sparkfun/SparkFun_Tristimulus_Color_Sensor-OPT4048/docs/examples.md

###Example 1: Basic Color Sensing

This first example just does some basic measurements. To find Example 1, go to **File** > **Examples** > **SparkFun Color Sensor OPT4048** > **example1_BasicColorSensing**:

<figure markdown>
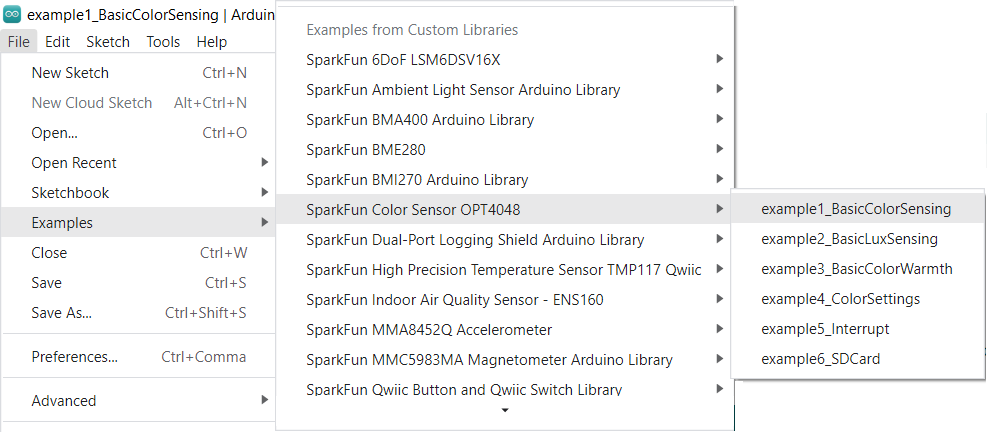
[picture p19: docs/assets/img/Example1_Menu.png]
Color Sensor OPT4048 Arduino Example 1

<figcaption markdown>Finding Example 1</figcaption>
</figure>

Alternatively, you can expand the link below and copy and paste the code into a shiny new Arduino sketch: 

??? "Example 1: Basic Color Sensing"
	```
	--8<-- "https://raw.githubusercontent.com/sparkfun/SparkFun_OPT4048_Arduino_Library/main/examples/example1_BasicColorSensing/example1_BasicColorSensing.ino"
	```

Make sure you've selected the correct board and port in the Tools menu and then hit the upload button. Once the code has finished uploading, go ahead and open a [Serial Monitor](https://learn.sparkfun.com/tutorials/terminal-basics). You should see something similar to the following. 

<figure markdown>
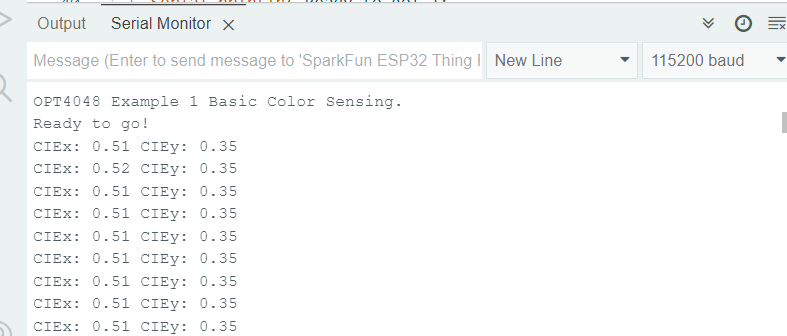
[picture p20: docs/assets/img/Example1_Output.png]
Color Sensor OPT4048 Arduino Example 1

<figcaption markdown>Example 1 Output</figcaption>
</figure>

The CIEx and CIEy values are going to fall somewhere between 0 and 1. Page 35 of the [datasheet](assets/board_files/opt4048.pdf) gives more detail on this, but generally speaking, you can map the predominant color of the space you're measuring using the following: 

<figure markdown>
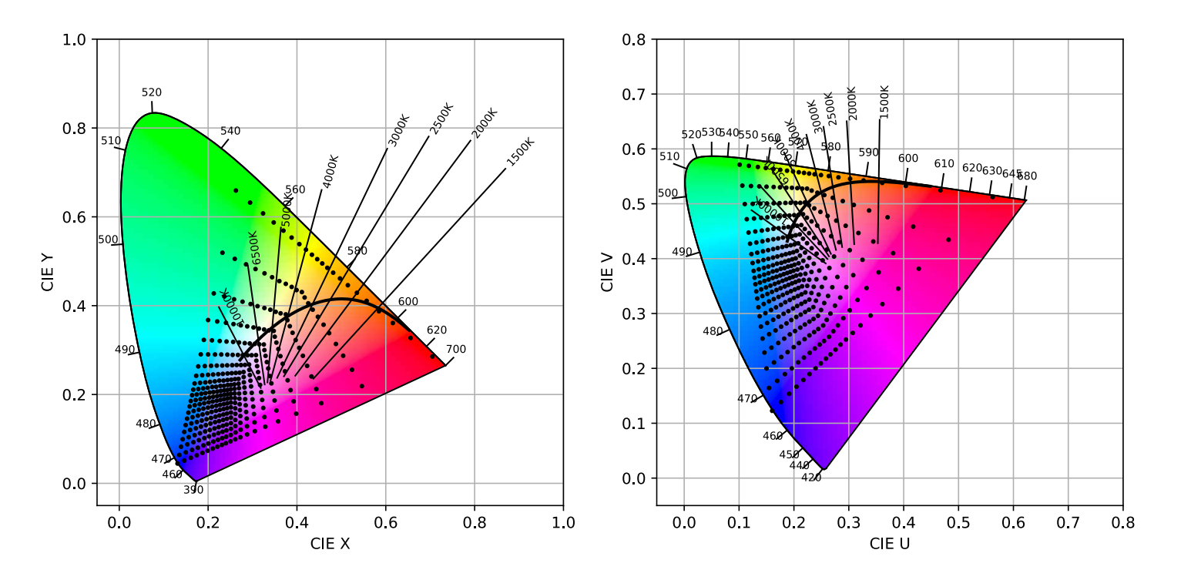
[picture p21: docs/assets/img/CIEMap.png]

<figcaption markdown>CIE XY and CIE UV space plots of color coordinates</figcaption>
</figure>

For more information on the CIE and CIY values, refer to the [CIE 1931 Color Space Wiki Page](https://en.wikipedia.org/wiki/CIE_1931_color_space).

###Example 2: Basic Lux Readings

This example measures the lux readings of the surrounding environment. To find Example 2, go to **File** > **Examples** > **SparkFun Color Sensor OPT4048** > **example2_BasicLuxSensing**:

<figure markdown>
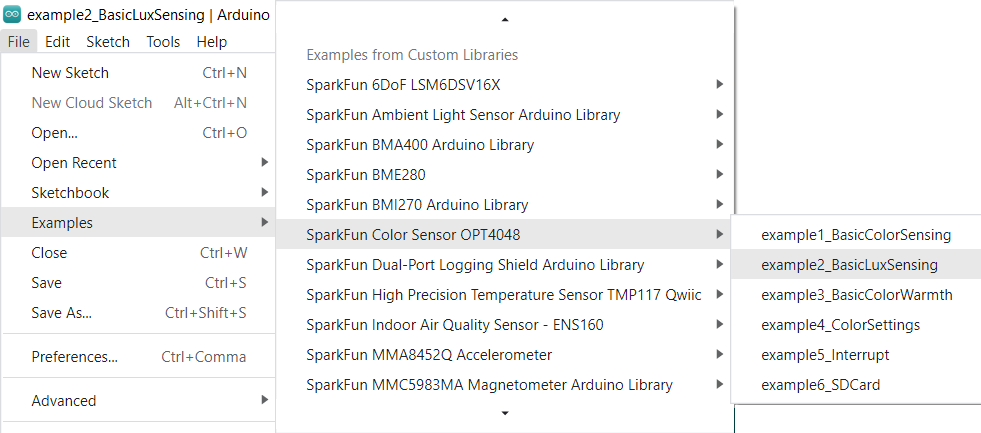
[picture p22: docs/assets/img/Example2_Menu.png]
Color Sensor OPT4048 Arduino Example 2

<figcaption markdown>Finding Example 2</figcaption>
</figure>

Alternatively, you can expand the link below and copy and paste the code into a shiny new Arduino sketch: 

??? "Example 2: Basic Lux Sensing Arduino Code"
	```
	--8<-- "https://raw.githubusercontent.com/sparkfun/SparkFun_OPT4048_Arduino_Library/main/examples/example2_BasicLuxSensing/example2_BasicLuxSensing.ino"
	```
 
Make sure you've selected the correct board and port in the Tools menu and then hit the upload button. Once the code has finished uploading, go ahead and open a [Serial Monitor](https://learn.sparkfun.com/tutorials/terminal-basics). You should see something similar to the following. 

<figure markdown>
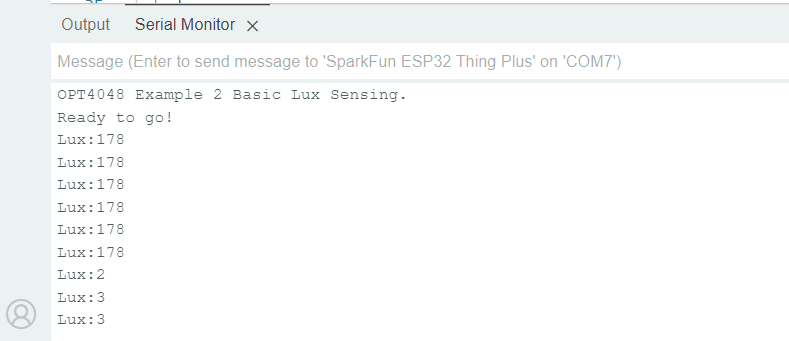
[picture p23: docs/assets/img/Example2_Output.png]
Color Sensor OPT4048 Arduino Example 2

<figcaption markdown>Example 2 Output</figcaption>
</figure>

Lux values will be measured anywhere from 2.15 mlux to 144 klux. Measurements here start at my general office lighting, and then I put my finger over the sensor. 

###Example 3: Basic Color Warmth

This example measures the basic color warmth. To find Example 3, go to **File** > **Examples** > **SparkFun Color Sensor OPT4048** > **example3_BasicColorWarmth**:

<figure markdown>
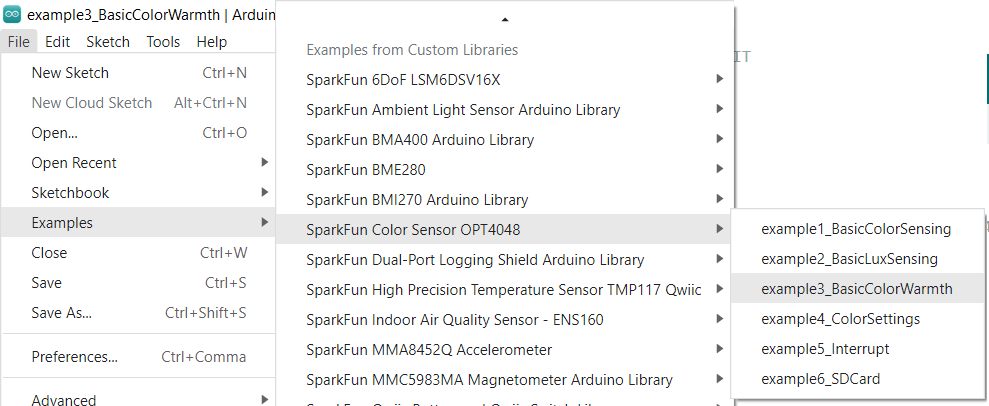
[picture p24: docs/assets/img/Example3_Menu.png]
Color Sensor OPT4048 Arduino Example 3

<figcaption markdown>Finding Example 3</figcaption>
</figure>

Alternatively, you can expand the link below and copy and paste the code into a shiny new Arduino sketch: 

??? "Example 3: Basic Color Warmth Arduino Code"
	```
	--8<-- "https://raw.githubusercontent.com/sparkfun/SparkFun_OPT4048_Arduino_Library/main/examples/example3_BasicColorWarmth/example3_BasicColorWarmth.ino"
	```

Make sure you've selected the correct board and port in the Tools menu and then hit the upload button. Once the code has finished uploading, go ahead and open a [Serial Monitor](https://learn.sparkfun.com/tutorials/terminal-basics). You should see something similar to the following. 

<figure markdown>
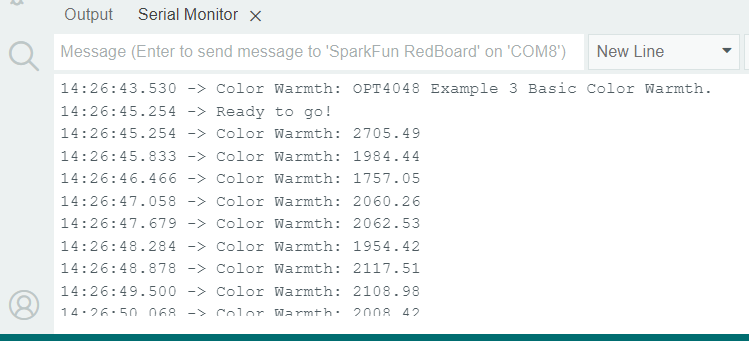
[picture p25: docs/assets/img/Example3_Output.png]
Color Sensor OPT4048 Arduino Example 3

<figcaption markdown>Example 3 Output</figcaption>
</figure>

Color warmth addresses the perceived "feel" of the color. Color temperatures over 5000 K are called "cool colors" (bluish), while lower color temperatures (2700–3000 K) are called "warm colors" (yellowish). 

<figure markdown>
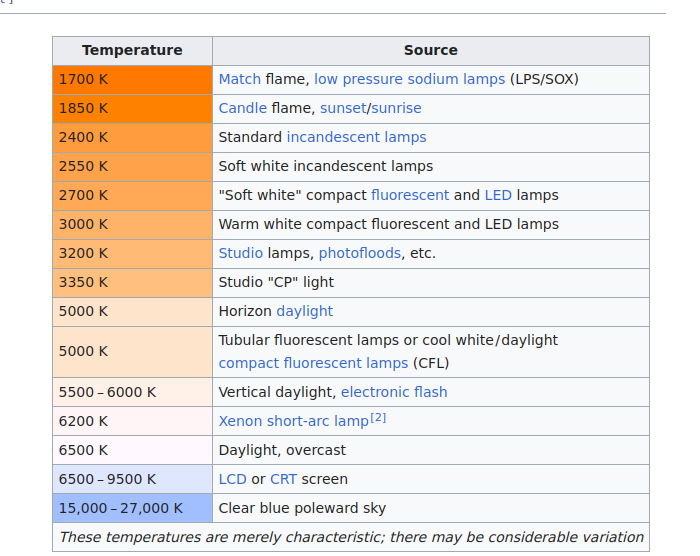
[picture p26: docs/assets/img/WarmthChart.png]

<figcaption markdown></figcaption>
</figure>

For more information on color temperature values, refer to the [Color temperature Wiki Page](https://en.wikipedia.org/wiki/Color_temperature).

###Example 4: Color Settings

The color settings example lists the conversion times for each channel. In a nutshell, the longer the conversion time, the more accurate the read values. To find Example 4, go to **File** > **Examples** > **SparkFun Color Sensor OPT4048** > **example4_ColorSettings**:

<figure markdown>
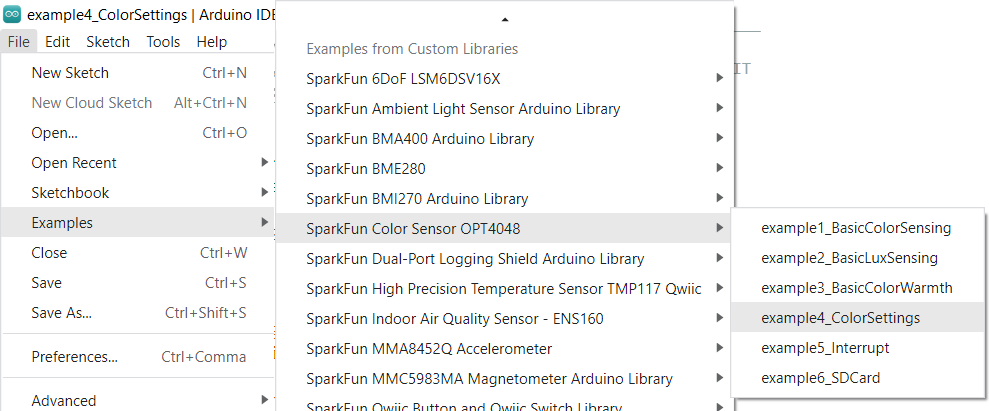
[picture p27: docs/assets/img/Example4_Menu.png]
Color Sensor OPT4048 Arduino Example 4

<figcaption markdown>Finding Example 4</figcaption>
</figure>

Alternatively, you can expand the link below and copy and paste the code into a shiny new Arduino sketch: 

??? "Example 4: Basic Color Senttings"
	```
	--8<-- "https://raw.githubusercontent.com/sparkfun/SparkFun_OPT4048_Arduino_Library/main/examples/example4_ColorSettings/example4_ColorSettings.ino"
	```

Make sure you've selected the correct board and port in the Tools menu and then hit the upload button. Once the code has finished uploading, go ahead and open a [Serial Monitor](https://learn.sparkfun.com/tutorials/terminal-basics). You should see something similar to the following. 

<figure markdown>
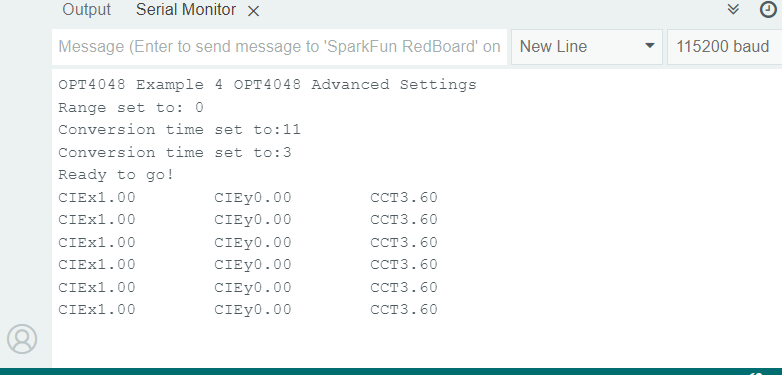
[picture p28: docs/assets/img/Example4_Output.png]
Color Sensor OPT4048 Arduino Example 4

<figcaption markdown>Example 4 Output</figcaption>
</figure>

###Example 5: Interrupt

The OPT4048 Color Sensor can be triggered by an interrupt if desired. Example 5 shows a simple setup case. To find Example 5, go to **File** > **Examples** > **SparkFun Color Sensor OPT4048** > **example5_Interrupt**:

<figure markdown>
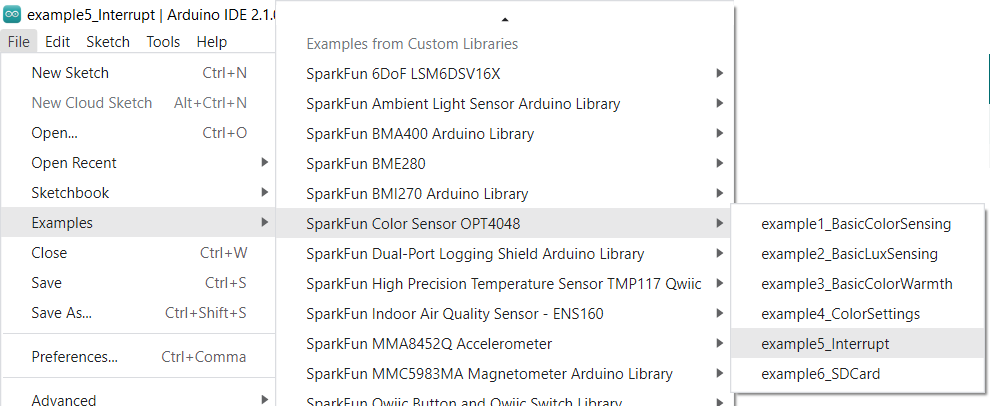
[picture p29: docs/assets/img/Example5_Menu.png]
Color Sensor OPT4048 Arduino Example 5

<figcaption markdown>Finding Example 5</figcaption>
</figure>

Alternatively, you can expand the link below and copy and paste the code into a shiny new Arduino sketch: 

??? "Example 5: Interrupt"
	```
	--8<-- "https://raw.githubusercontent.com/sparkfun/SparkFun_OPT4048_Arduino_Library/main/examples/example5_Interrupt/example5_Interrupt.ino"
	```

The hardware setup should look something like this: 

<figure markdown>
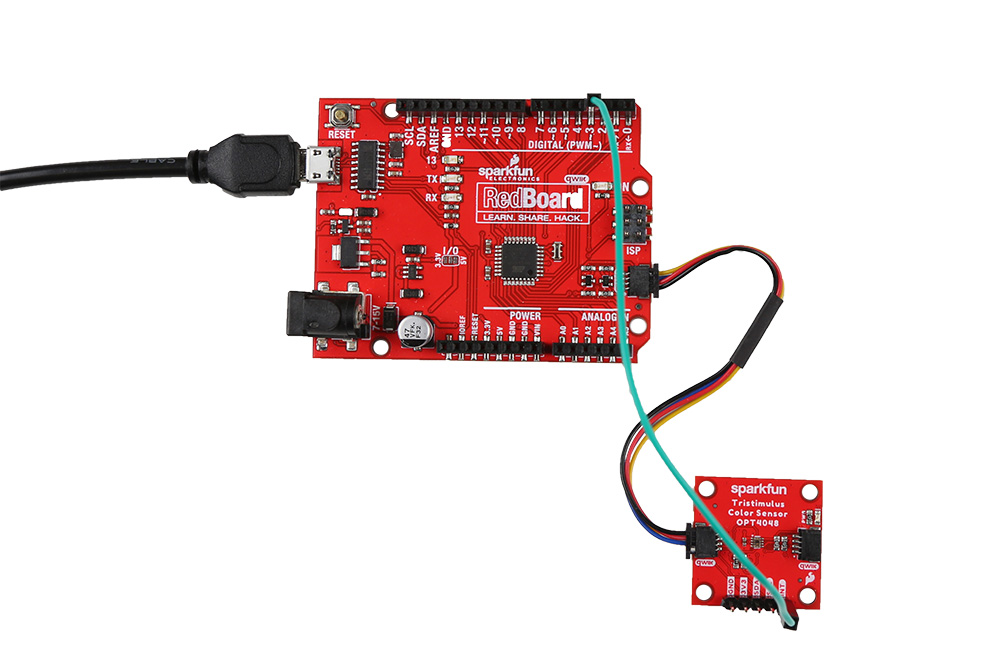
[picture p30: docs/assets/img/TriColorSensor_3.jpg]
Color Sensor OPT4048 Arduino Example 5 Setup

<figcaption markdown>Example 5 Setup</figcaption>
</figure>

The example code sets the interrupt pin as Pin 3, but if you change the code, you'll need to change the hardware setup. 

Make sure you've selected the correct board and port in the Tools menu and then hit the upload button. Once the code has finished uploading, go ahead and open a [Serial Monitor](https://learn.sparkfun.com/tutorials/terminal-basics). 

<figure markdown>
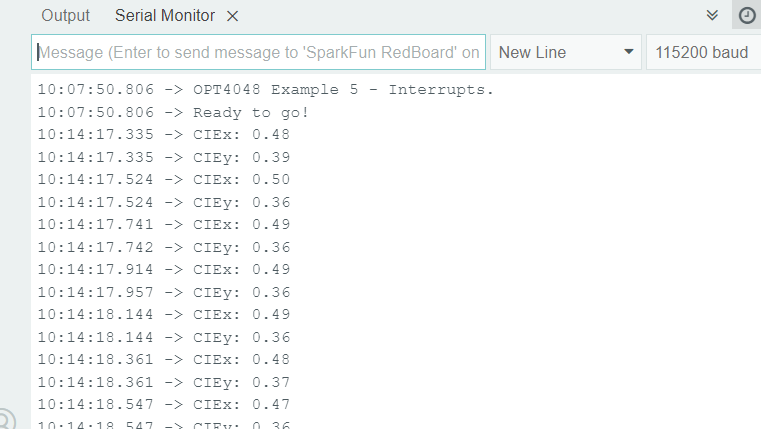
[picture p31: docs/assets/img/Example5_Output.png]
Color Sensor OPT4048 Arduino Example 5

<figcaption markdown>Example 5 Output</figcaption>
</figure>

The output here sits at "Ready to go" until pin 3 is pulled low, then the output starts to roll by.
