sparkfun/SparkFun_Tristimulus_Color_Sensor-OPT4048/docs/introduction.md

---
icon: material/book-open-page-variant
---

## Introduction

<!-- Double Product Card -->

<section class="grid cards col-2"markdown>

-	<a href="https://www.sparkfun.com/products/22638">
	**SparkFun Tristimulus Color Sensor - OPT4048DTSR (Qwiic)**<br>
	**SKU:** SEN-22638

	---

	<figure markdown>
	Product Thumbnail
	</figure>
	</a>

    The SparkFun Tristimulus Color Sensor - OPT4048DTSR (Qwiic) is built around the OPT4048 High Speed High Precision Tristimulus XYZ Color Sensor from Texas Instruments. It is a 1" x 1" Qwiic enabled board that can support up to 4 devices on a shared I<sup>2</sup>C bus - each capable of measuring four channels with specific engineered spectral responses.

	<center>
    [Purchase from SparkFun :fontawesome-solid-cart-plus:{ .heart }](https://www.sparkfun.com/products/22638){ .md-button .md-button--primary }
    </center>

-	<a href="https://www.sparkfun.com/products/22639">
	**SparkFun Mini Tristimulus Color Sensor - OPT4048DTSR (Qwiic)**<br>
	**SKU:** SEN-22639

	---

	<figure markdown>
	Product Thumbnail
	</figure></a>

    The Mini version of the SparkFun Tristimulus Color Sensor - OPT4048DTSR (Qwiic) maintains all the functionality of the 1" x 1" breakout board, but in a smaller footprint. 

	<center>
	[Purchase from SparkFun :fontawesome-solid-cart-plus:{ .heart }](https://www.sparkfun.com/products/22639){ .md-button .md-button--primary }
	</center>

</section>

## Required Materials
To get started, users will need a few items. Now some users may already have a few of these items, feel free to modify your cart accordingly.

<div class="grid cards hide col-4" markdown>

-   <a href="https://www.sparkfun.com/products/22638">
    <figure markdown>
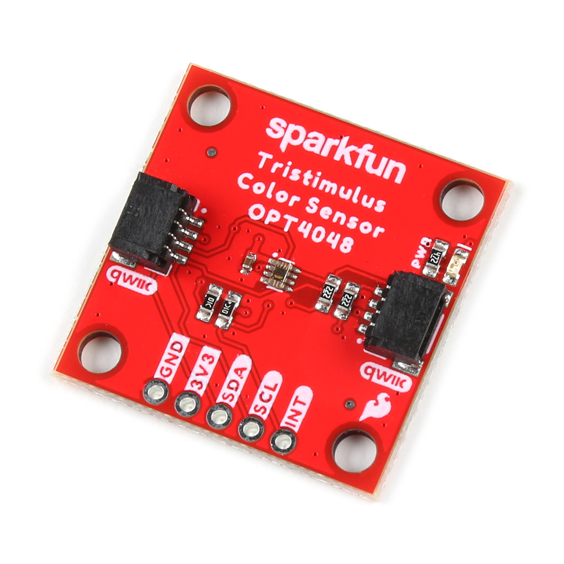
[picture p32: docs/assets/img/22638-SparkFun-Tristimulus-Color-Sensor-01.jpg]
    
    </figure>

    ---

    **SparkFun Tristimulus Color Sensor - OPT4048DTSR (Qwiic)**<br>
    SEN-22638</a>

-   <a href="https://www.sparkfun.com/products/22639">
    <figure markdown>
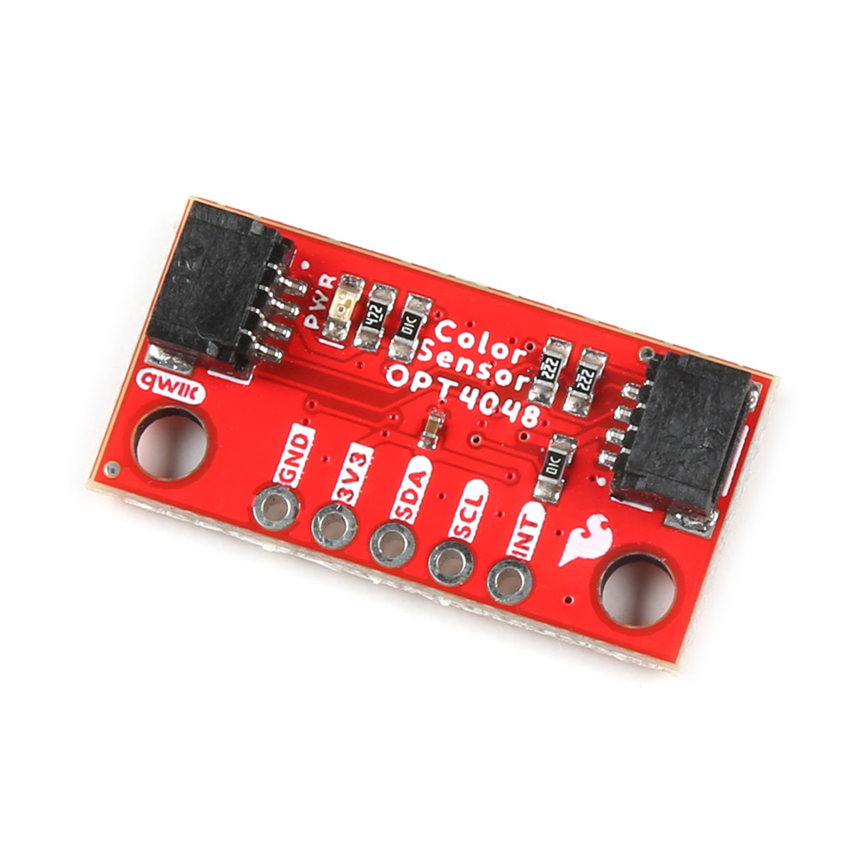
[picture p33: docs/assets/img/22639-SparkFun-Mini-Tristimulus-Color-Sensor-01.jpg]
    
    </figure>

    ---

    **SparkFun Mini Tristimulus Color Sensor - OPT4048DTSR (Qwiic)**<br>
    SEN-22639</a>

-   <a href="https://www.sparkfun.com/products/15123">
    <figure markdown>
    Product Thumbnail
    </figure>

    ---

    **SparkFun RedBoard Qwiic**<br>
    DEV-15123</a>

-   <a href="https://www.sparkfun.com/products/17259">
    <figure markdown>
    Product Thumbnail
    </figure>

    ---

    **Flexible Qwiic Cable - 100mm**<br>
    PRT-17259</a>

</div>

## Suggested Reading

If you aren’t familiar with the following concepts, we recommend checking out these tutorials before continuing.

<div class="grid cards hide col-4" markdown>

-   <a href="https://www.sparkfun.com/qwiic">
    <figure markdown>
    Product Thumbnail
    </figure>
    <center>**Qwiic Connect System**</center></a>

-   <a href="https://www.sparkfun.com/I2C">
    <figure markdown>
    Product Thumbnail
    </figure>
    <center>**I<sup>2</sup>C**</center></a>

-   <a href="https://learn.sparkfun.com/tutorials/light">
    <figure markdown>
    Product Thumbnail
    </figure>
    <center>**Light**</center></a>

</div>
