sparkfun/SparkFun_Tristimulus_Color_Sensor-OPT4048/docs/resources.md

# Resources
<!-- This section should include all the relevant documentation and product files (Eagle files, schematic, datasheet(s), landing pages, etc. and any relevant tutorials to go beyond the Hookup Guide.) -->

For more resources related to the SparkFun Tristimulus Color Sensor - OPT4048DTSR (Qwiic) boards, check out the links listed here: 

SparkFun Tristimulus Color Sensor - OPT4048DTSR (Qwiic):

* [Product Page](https://www.sparkfun.com/products/22638)
* [Schematic](assets/board_files/22638-SparkFun_Color_Sensor_OPT4048-Schematic.pdf) (PDF)
* [Eagle Files](assets/board_files/22638-SparkFun_Color_Sensor_OPT4048-EagleFiles.zip) (ZIP)
* [Board Dimensions](assets/board_files/22638-SparkFun_Color_Sensor_OPT4048-BoardOutline.png) (PDF)

SparkFun Mini Tristimulus Color Sensor - OPT4048DTSR (Qwiic):

* [Product Page](https://www.sparkfun.com/products/22639)
* [Schematic](assets/board_files/22639-SparkFun_Color_Sensor_OPT4048-Mini-Schematic.pdf) (PDF)
* [Eagle Files](assets/board_files/22639-SparkFun_Color_Sensor_OPT4048_Mini-EagleFiles.zip) (ZIP)
* [Board Dimensions](assets/board_files/22639-SparkFun_Color_Sensor_OPT4048-Mini-BoardOutline.png) (PDF)

General: 

* [Hardware GitHub Respository](https://github.com/sparkfun/SparkFun_Tristimulus_Color_Sensor-OPT4048)
* [Arduino Library](https://github.com/sparkfun/SparkFun_OPT4048_Arduino_Library) 
* [OPT4048 Datasheet](assets/board_files/opt4048.pdf) (PDF)
