sparkfun/SparkFun_Tristimulus_Color_Sensor-OPT4048/docs/assets/img/450px-PlanckianLocus.png

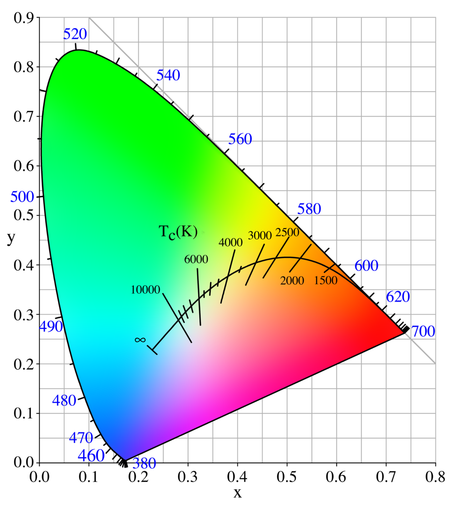
docs/assets/img/450px-PlanckianLocus.png
