sparkfun/SparkFun_Tristimulus_Color_Sensor-OPT4048/docs/assets/img/22639-SparkFun_Tristimulus_Color_Sensor-GPIO.jpg

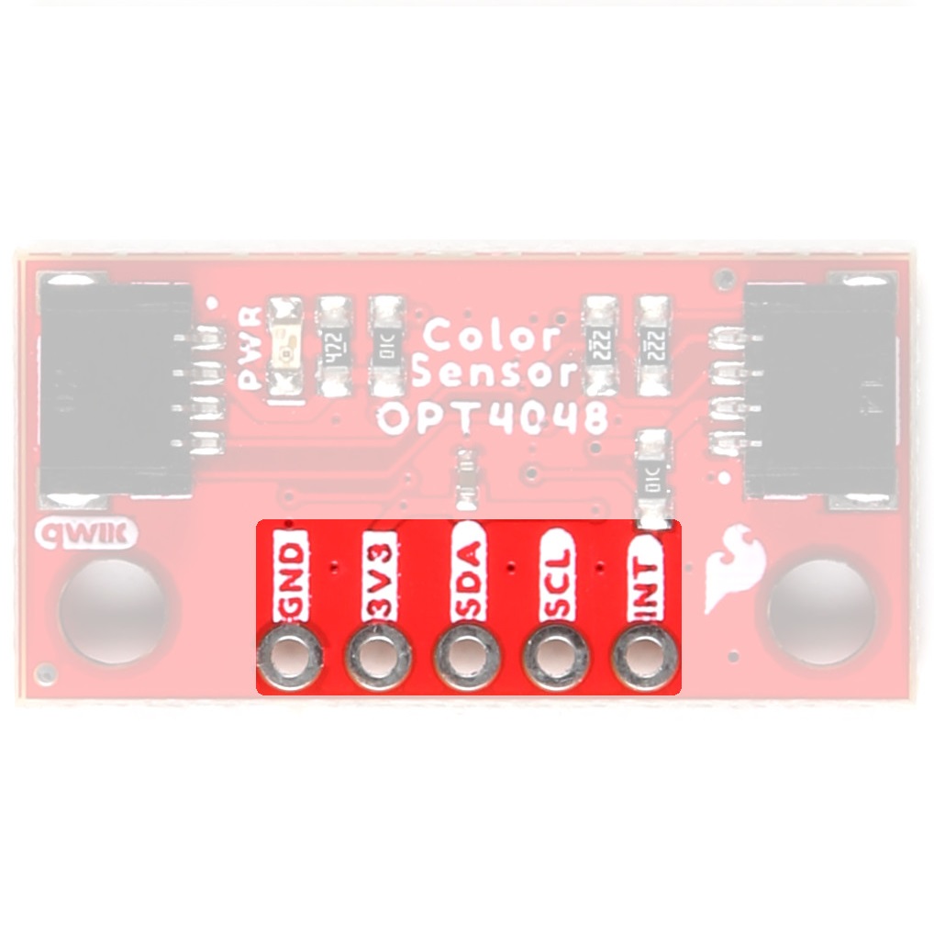
docs/assets/img/22639-SparkFun_Tristimulus_Color_Sensor-GPIO.jpg
