sparkfun/SparkFun_Tristimulus_Color_Sensor-OPT4048/docs/assets/img/CIE1931xy_CIERGB.svg.png

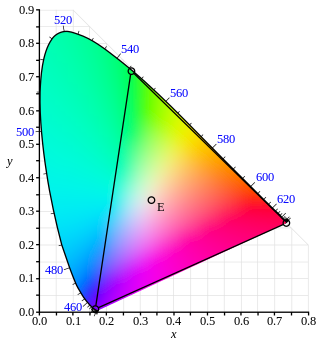
docs/assets/img/CIE1931xy_CIERGB.svg.png
