sparkfun/SparkFun_Tristimulus_Color_Sensor-OPT4048/docs/hardware_assembly.md

---
icon: material/tools
---

<!-- This section covers any assembly steps needed to complete the guide. Can be very simple but should include a simple assembly (Qwiic, USB, etc.) and a Soldered Assmebly section link to the PTH Soldering Tutorial-->

## Qwiic Assembly

Connecting to the Tristimulus Color breakout is simple. You will just need a microcontroller to process the data when using the OPT4048 and a Qwiic cable. In this case, we used a SparkFun RedBoard Qwiic.

<figure markdown>
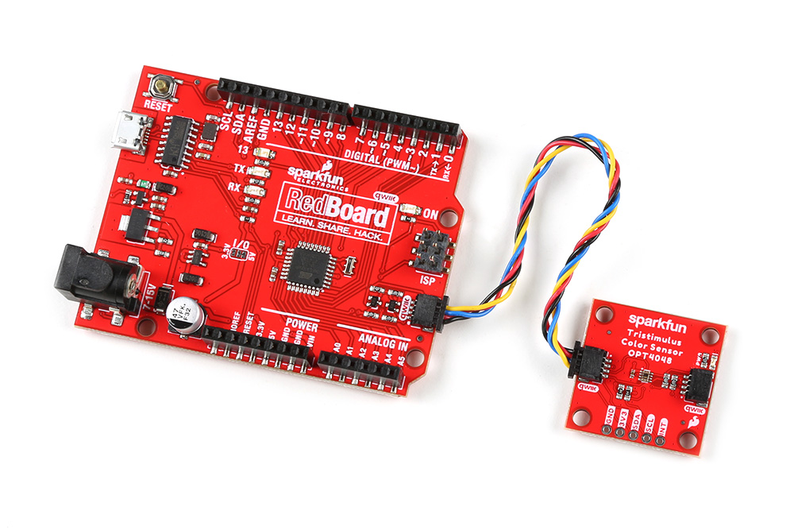
[picture p38: docs/assets/img/22638-SparkFun_Tristimulus_Color_Sensor-Hookup.jpg]
SparkFun Tristimulus Color Sensor Hooked Up to RedBoard Qwiic via a Qwiic Cable

<figcaption markdown>SparkFun Tristimulus Color Sensor Hooked Up to RedBoard Qwiic via a Qwiic Cable</figcaption>
</figure>

<figure markdown>
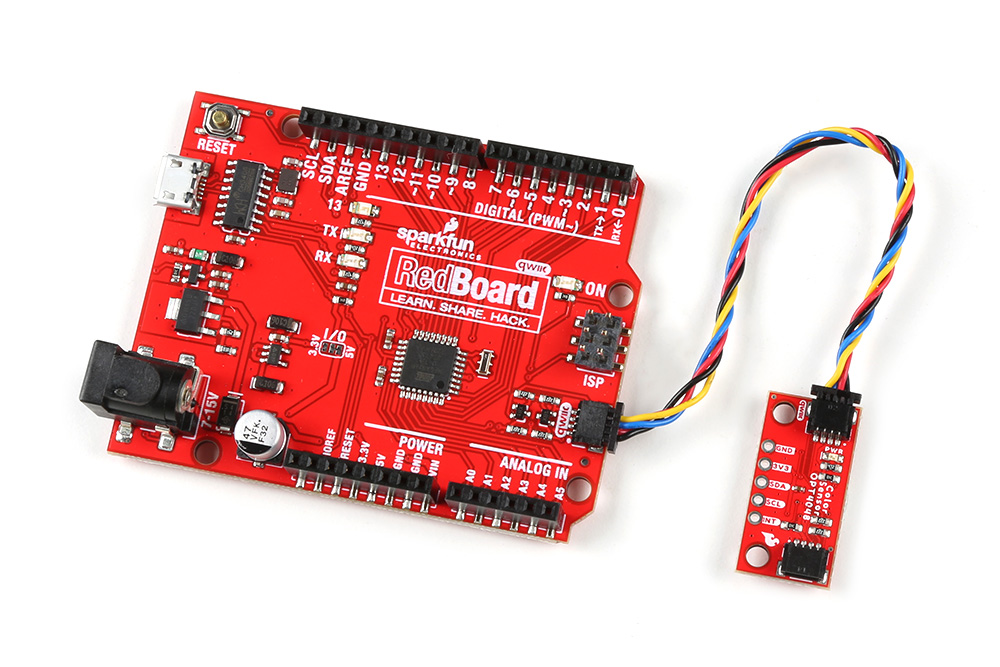
[picture p39: docs/assets/img/22639-SparkFun_Tristimulus_Color_Sensor-Hookup.jpg]
SparkFun Mini Tristimulus Color Sensor Hooked Up to RedBoard Qwiic via a Qwiic Cable

<figcaption markdown>SparkFun Mini Tristimulus Color Sensor Hooked Up to RedBoard Qwiic via a Qwiic Cable</figcaption>
</figure>

## Soldered Assembly

If you prefer to use the plated through holes on the board, you'll need to solder headers to them. Here we've soldered male headers to the breakout board and attached the jumpers as follows: 

* Yellow = <b><font color="yellow">SCL</font></b>
* Blue = <b><font color="blue">SDA</font></b>
* Red = <b><font color="red">3.3V</font></b>
* Black = <b>GND</b>
* Green = <b><font color="green">Interrupt</font></b>

<div class="grid cards hide" markdown>

-   <figure markdown>
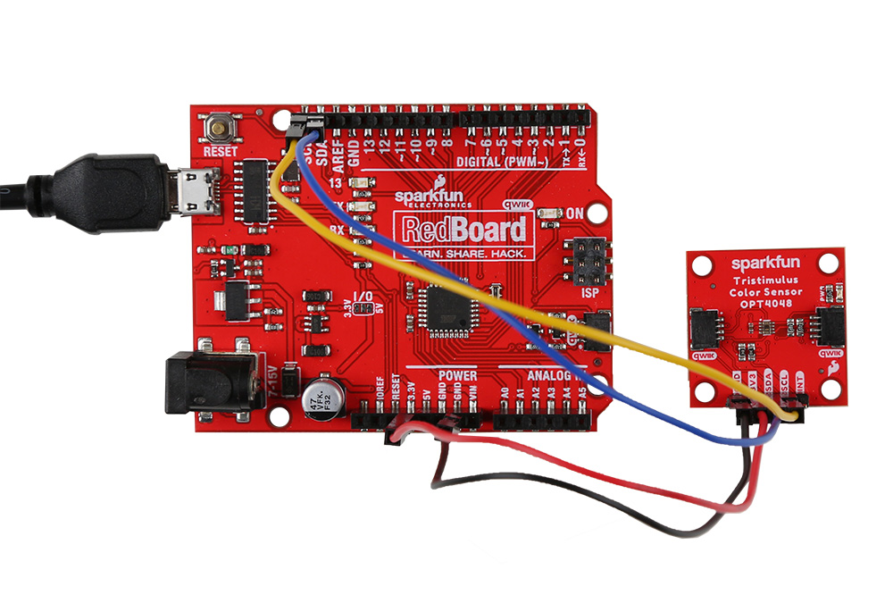
[picture p40: docs/assets/img/TriColorSensor_1.jpg]
	
	<figcaption markdown>
	PTH Hookup of Tristimulus Color Sensor
	</figcaption>
	</figure>

-   <figure markdown>
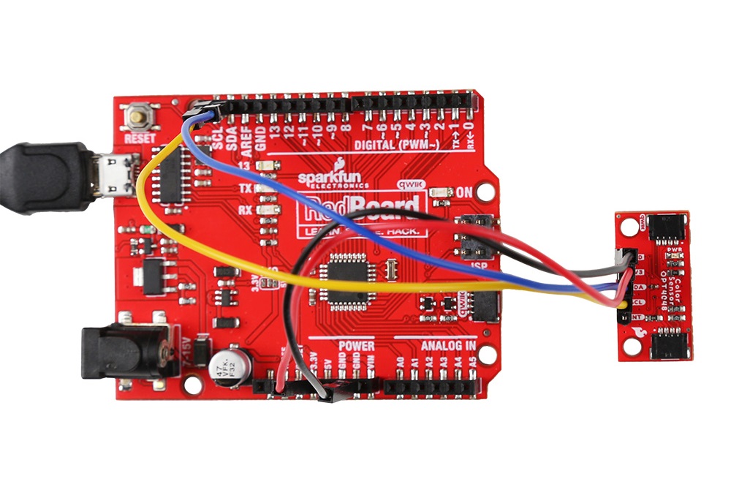
[picture p41: docs/assets/img/TriColorSensor_2.jpg]
	
	<figcaption markdown>
	PTH Hookup of Mini Tristimulus Color Sensor
	</figcaption>
	</figure>

</div>

<center>
<table class="pdf">
	<tr>
		<td align="center">
			<br>
			<i>PTH Hookup of Tristimulus Color Sensor</i>
		</td>
		<td align="center">
			<br>
			<i>PTH Hookup of Mini Tristimulus Color Sensor</i>
		</td>
	<tr>
</table>
</center>

<center>Click on either image for a closer view.</center>

## New to Soldering?

If you have never soldered before or need a quick refresher, check out our [How to Solder: Through-Hole Soldering](https://learn.sparkfun.com/tutorials/how-to-solder-through-hole-soldering) guide.

<p align="center">
	<a href="https://learn.sparkfun.com/tutorials/5">
	Tutorial's thumbnail<br>
    How to Solder: Through-Hole Soldering</a>
</p>
