sparkfun/SparkFun_Tristimulus_Color_Sensor-OPT4048/Production/1x1/ordering_instructions.txt

panel size, 169x117mm
PCB thickness, 1.6mm
number of layers, 2
soldermask color, Red
silkscreen color, White
oz copper, 1oz
finish, HASL lead free
stencils, top
pcs per panel, 24
min trace width, 0.2032mm / 0.0080in
min drill size, 0.3048mm / 0.0120in
