sparkfun/SparkFun_Tristimulus_Color_Sensor-OPT4048/Production/Mini/ordering_instructions.txt

panel size, 117x172mm
PCB thickness, 1.6mm
number of layers, 2
soldermask color, Red
silkscreen color, White
oz copper, 1oz
finish, HASL lead free
stencils, top+bottom
pcs per panel, 48
min trace width, 0.1524mm / 0.0060in
min drill size, 0.3048mm / 0.0120in
