sparkfun/SparkFun_Tristimulus_Color_Sensor-OPT4048/docs/assets/board_files/22638-SparkFun_Color_Sensor_OPT4048-Schematic.pdf

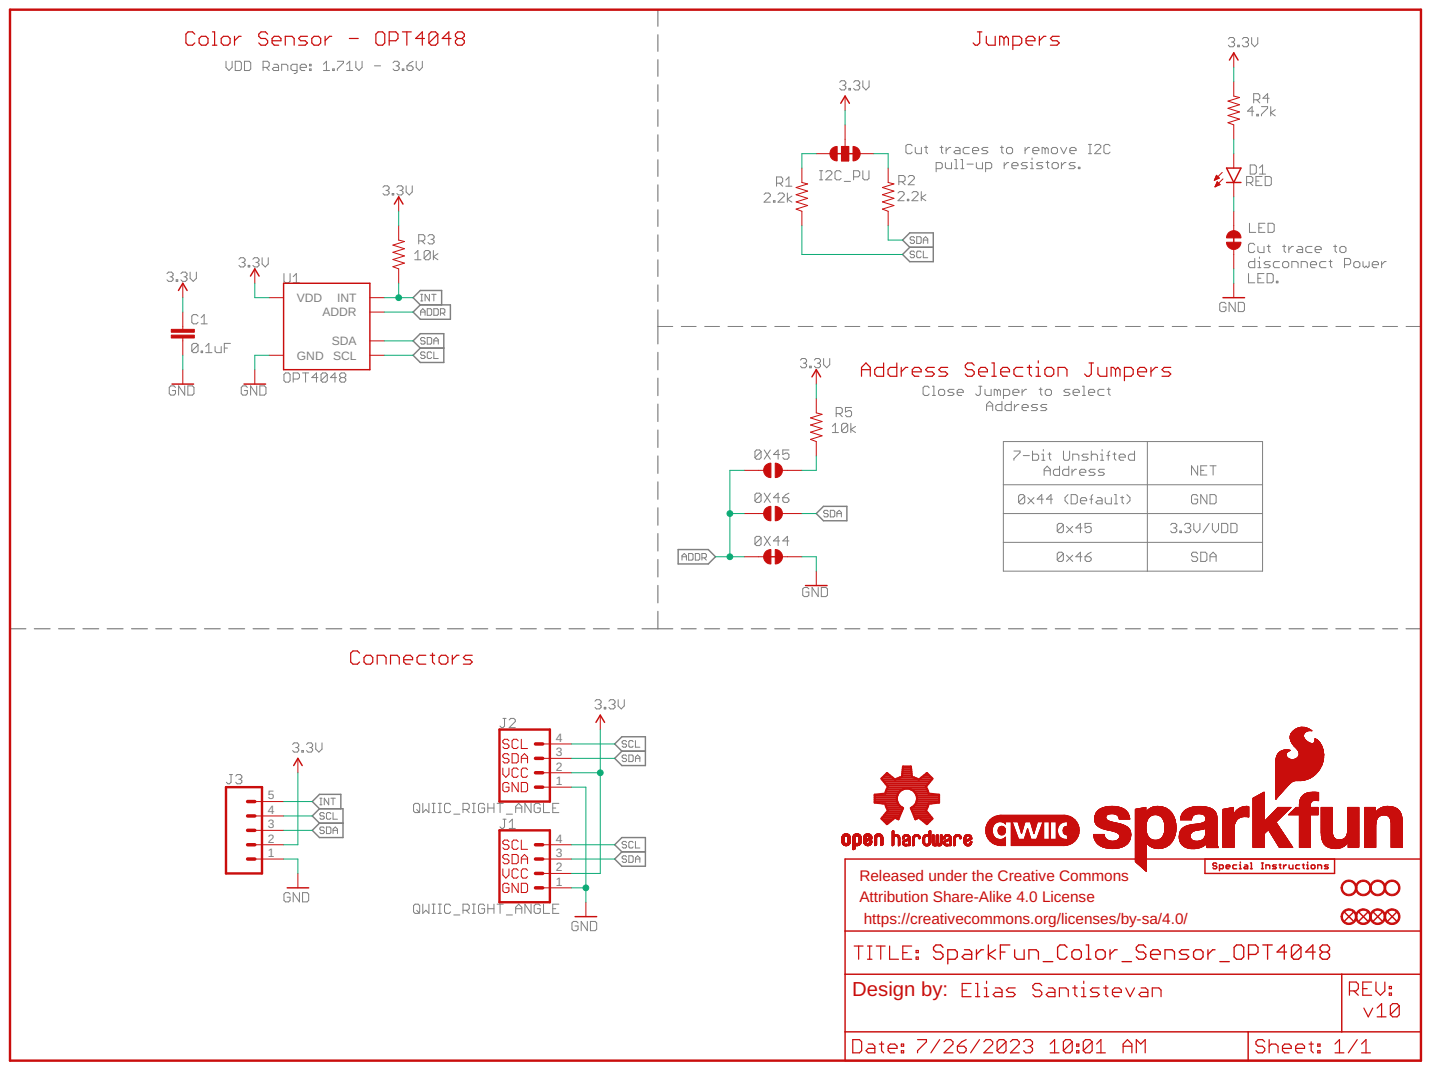
[picture p42: page 1]

https://creativecommons.org/licenses/by-sa/4.0/
