sparkfun/SparkFun_Tristimulus_Color_Sensor-OPT4048/docs/assets/board_files/22639-SparkFun_Color_Sensor_OPT4048-Mini-Schematic.pdf

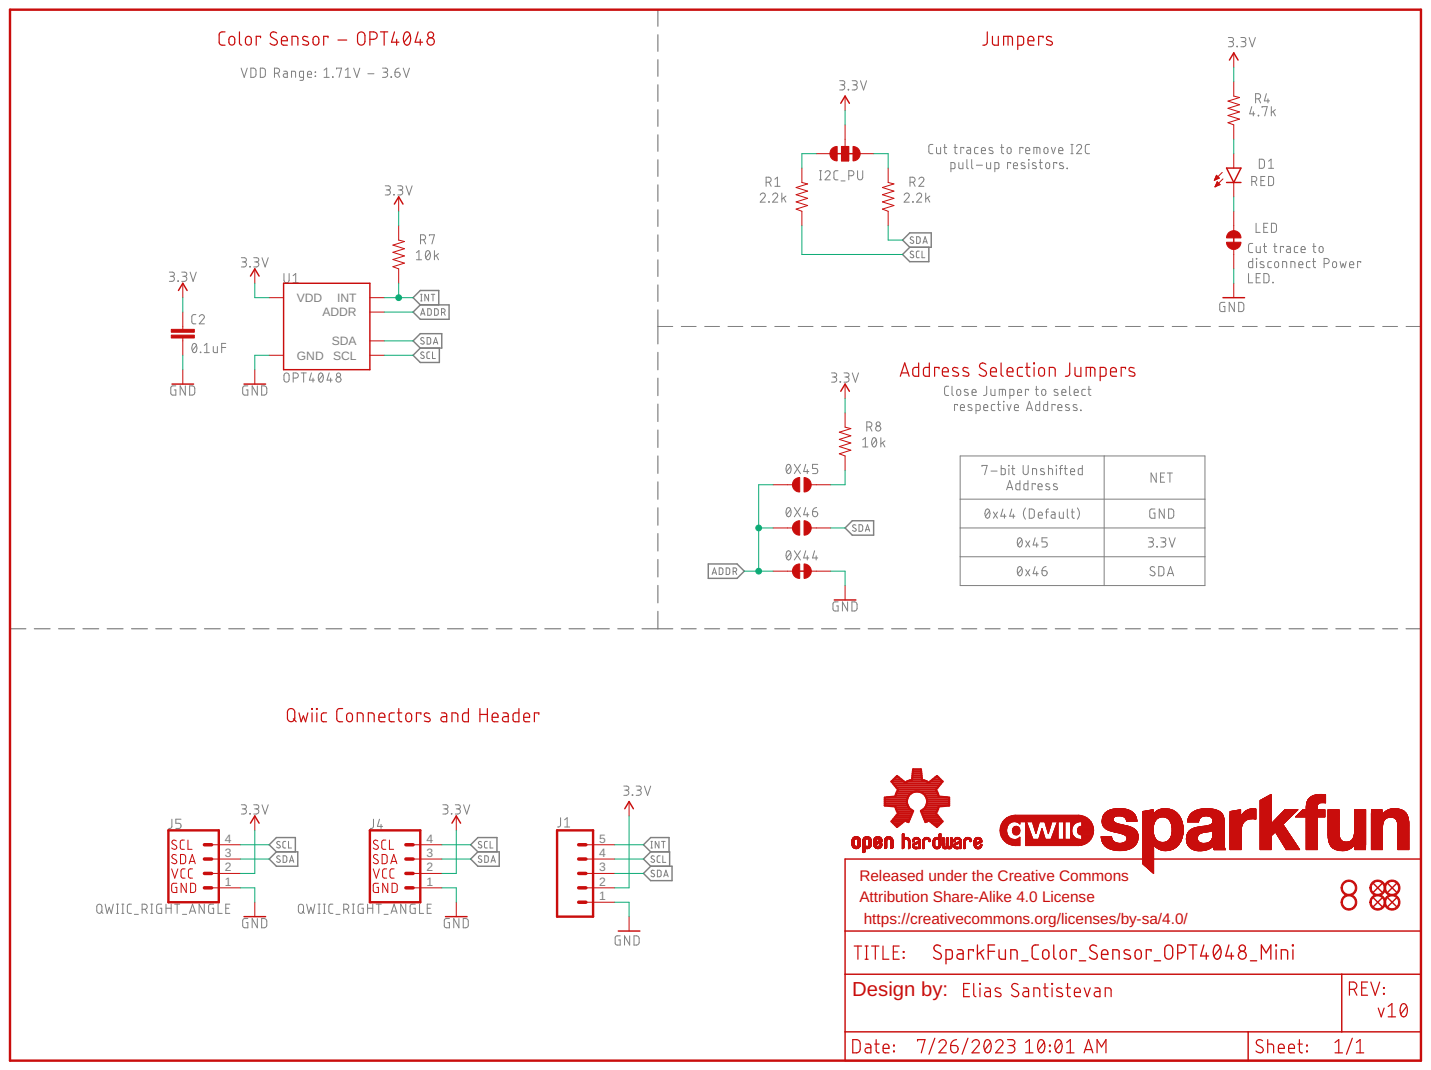
[picture p43: page 1]

https://creativecommons.org/licenses/by-sa/4.0/
