sparkfun/SparkFun_Tristimulus_Color_Sensor-OPT4048/Hardware/Qwiic/SparkFun_Color_Sensor_OPT4048.brd

## EAGLE design Hardware/Qwiic/SparkFun_Color_Sensor_OPT4048.brd (2023-07-21)

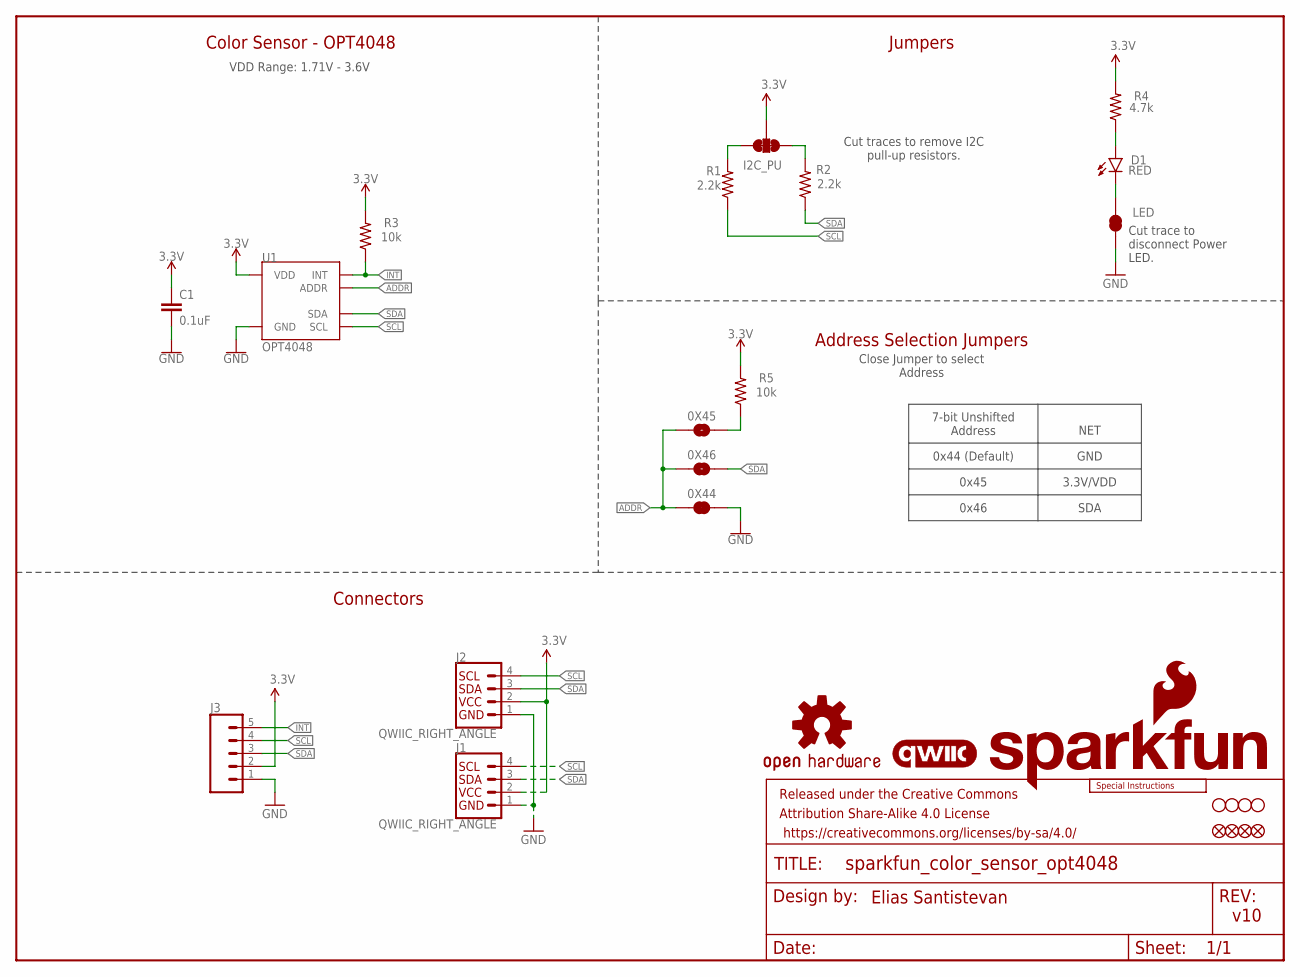
[picture p44: schematic SparkFun_Color_Sensor_OPT4048.sch]

Parts:
0X44: JUMPER-SMT_2_NC_TRACE_SILK; SMT-JUMPER_2_NC_TRACE_SILK
0X45, 0X46: JUMPER-SMT_2_NO_SILK; SMT-JUMPER_2_NO_SILK
C1: 0.1uF; 0402-TIGHT
D1: RED; LED-0603
FD1, FD2: FIDUCIALUFIDUCIAL; FIDUCIAL-MICRO
FID1, FID2: FIDUCIALUFIDUCIAL; FIDUCIAL-MICRO
FRAME1: FRAME-LETTER; CREATIVE_COMMONS
I2C_PU: S_MODE; SMT-JUMPER_3_2-NC_TRACE_SILK
J1, J2: QWIIC_RIGHT_ANGLE; JST04_1MM_RA
J3: CONN_05NO_SILK; 1X05_NO_SILK
LED: JUMPER-SMT_2_NC_TRACE_SILK; SMT-JUMPER_2_NC_TRACE_SILK
LOGO1: QWIIC_LOGO_4MM; QWIIC_4MM
LOGO2: OSHW-LOGOMINI; OSHW-LOGO-MINI
LOGO3: SFE_LOGO_NAME_FLAME.1_INCH; SFE_LOGO_NAME_FLAME_.1
LOGO4: SPECIAL_INSTRUCTIONS-ORDERING; ORDERING_INSTRUCTIONS
R1, R2: 2.2k; 0603
R3, R5: 10k; 0603
R4: 4.7k; 0603
STANDOFF1, STANDOFF2, STANDOFF3, STANDOFF4: STAND-OFFTIGHT; STAND-OFF-TIGHT
U1: OPT4048; FCSOT

Connections:
3.3V: C1.1, I2C_PU.2, J1.2, J2.2, J3.2, R3.2, R4.2, R5.2, U1.P1 (VDD)
ADDR: 0X44.1, 0X45.1, 0X46.1, U1.P2 (ADDR)
GND: 0X44.2, C1.2, J1.1, J2.1, J3.1, LED.1, U1.P4 (GND)
INT: J3.5, R3.1, U1.P7 (INT)
unnamed: D1.A, R4.1
unnamed: D1.C, LED.2
unnamed: 0X45.2, R5.1
unnamed: I2C_PU.1, R1.2
unnamed: I2C_PU.3, R2.2
SCL: J1.4, J2.4, J3.4, R1.1, U1.P5 (SCL)
SDA: 0X46.2, J1.3, J2.3, J3.3, R2.1, U1.P8 (SDA)

Notes on the sheet:
Color Sensor - OPT4048
Cut traces to remove I2C pull-up resistors.
VDD Range: 1.71V - 3.6V
v10
Jumpers
Cut trace to disconnect Power LED.
Connectors
Elias Santistevan
7-bit Unshifted Address
0x44 (Default)
0x45
0x46
GND
3.3V/VDD
SDA
Address Selection Jumpers
NET
Close Jumper to select Address

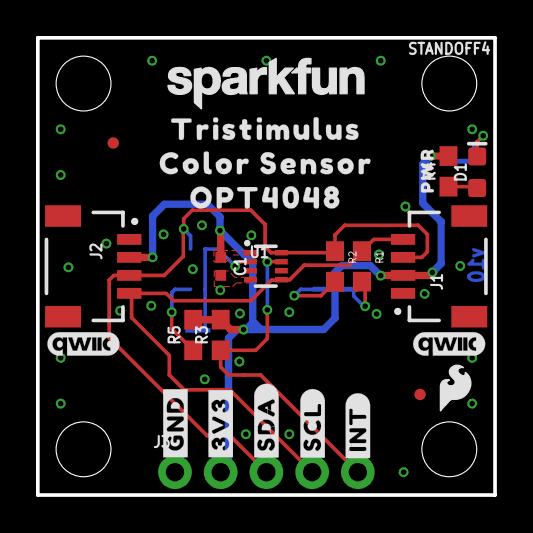
[picture p45: board SparkFun_Color_Sensor_OPT4048.brd from above]

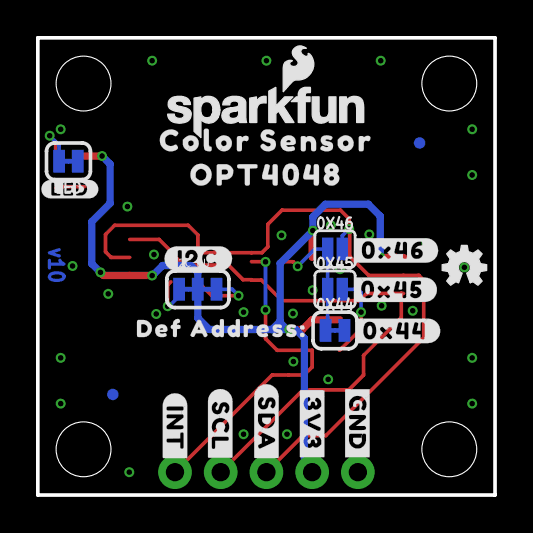
[picture p46: board SparkFun_Color_Sensor_OPT4048.brd from below]

Board: 2 copper layers, 25.4 x 25.4 mm, 54 parts (22 on the bottom side), 11 nets.

Other parts of the board:
LOGO5: QWIIC_LOGO_4MM; QWIIC_4MM
U$1, U$15: #3V3#1
U$2, U$17: #GND#0
U$3: #SDA#1
U$4: #SDA#4
U$5, U$22: #SCL#5
U$6: #INT#3
U$7: #INT#9
U$8: #0X44#18
U$9, U$12: COLOR_SENSOR227
U$10: #I2C#227
U$11: #0X45#18
U$13: TRISTIMULUS228
U$14, U$19: OPT4048229
U$16: #LED#11
U$18: SFE_LOGO_NAME_.1
U$20: DEF_ADDRESS#_17
U$21: #0X46#18
U$28: PWR8
U$29: SFE_LOGO_FLAME_.1
