sparkfun/SparkFun_Tristimulus_Color_Sensor-OPT4048/Production/Mini/SparkFun_Color_Sensor_OPT4048_Mini-Panel.brd

## EAGLE design Production/Mini/SparkFun_Color_Sensor_OPT4048_Mini-Panel.brd (2023-07-21)

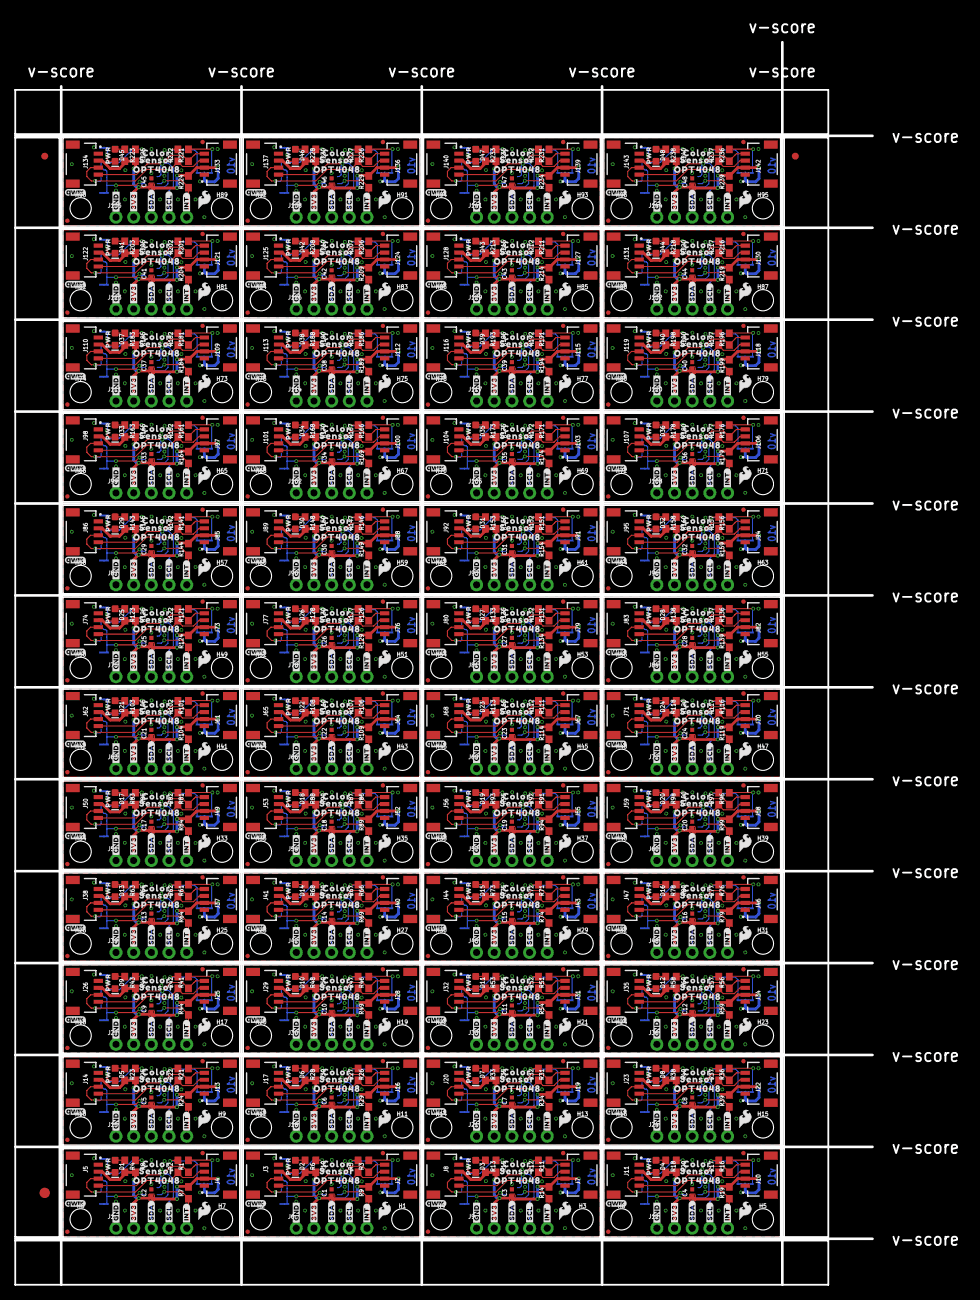
[picture p47: board SparkFun_Color_Sensor_OPT4048_Mini-Panel.brd from above]

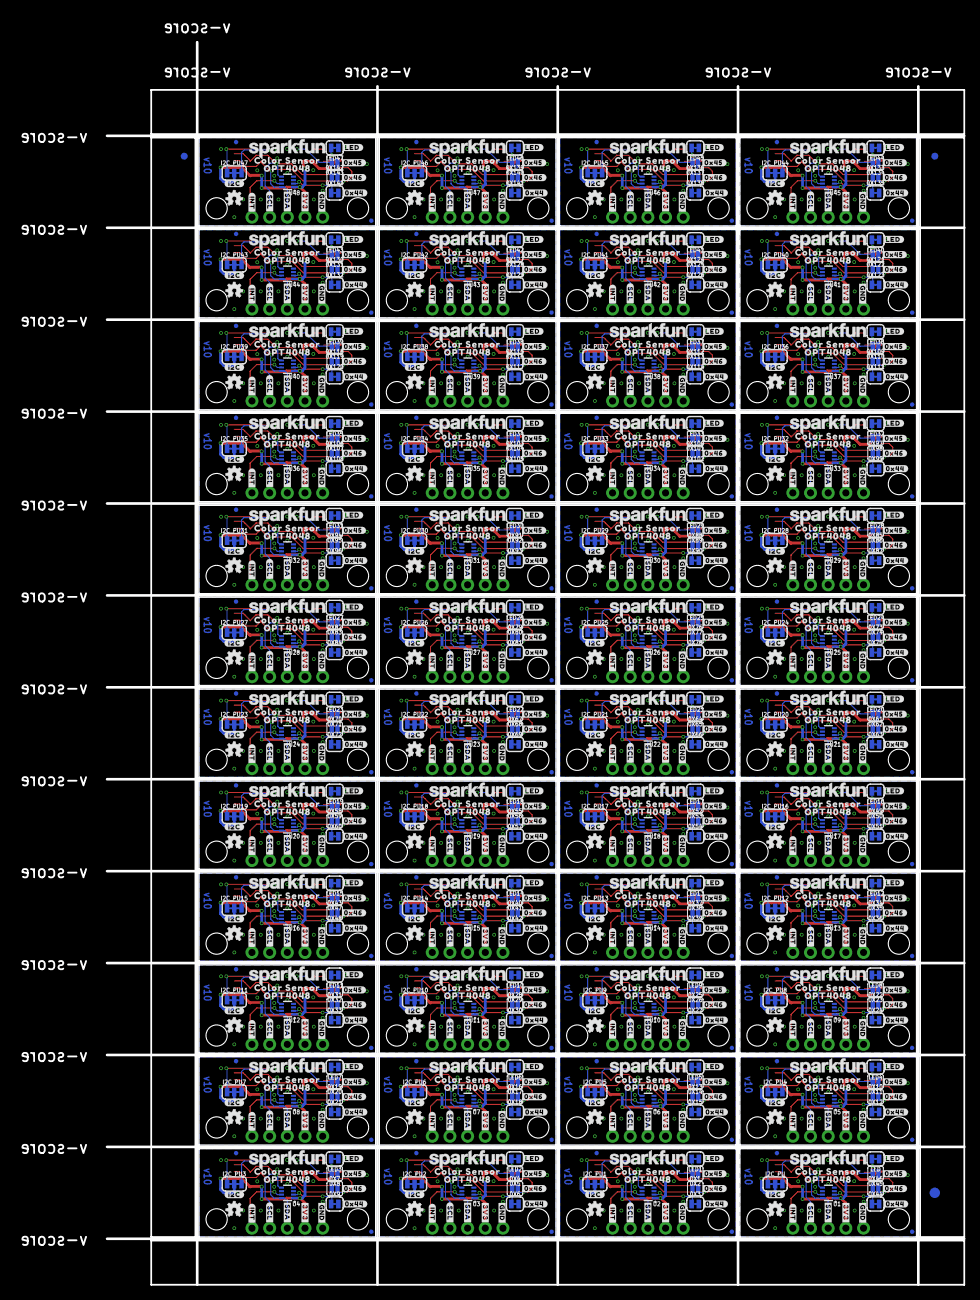
[picture p48: board SparkFun_Color_Sensor_OPT4048_Mini-Panel.brd from below]

Board: 2 copper layers, 123.2 x 178.6 mm, 2406 parts (1059 on the bottom side), 528 nets.

Parts:
0X1, 0X2, 0X4, 0X5, 0X7, 0X8, 0X10, 0X11, 0X13, 0X14, 0X16, 0X17, 0X19, 0X20, 0X22, 0X23, 0X25, 0X26, 0X28, 0X29, 0X31, 0X32, 0X34, 0X35, 0X37, 0X38, 0X40, 0X41, 0X43, 0X45, 0X46, 0X47, 0X49, 0X50, 0X52, 0X53, 0X55, 0X56, 0X58, 0X59, 0X61, 0X62, 0X64, 0X65, 0X67, 0X68, 0X70, 0X71, 0X73, 0X74, 0X76, 0X77, 0X79, 0X80, 0X82, 0X83, 0X85, 0X86, 0X88, 0X89, 0X91, 0X92, 0X94, 0X95, 0X97, 0X98, 0X100, 0X101, 0X103, 0X104, 0X106, 0X107, 0X109, 0X110, 0X112, 0X113, 0X115, 0X116, 0X118, 0X119, 0X121, 0X122, 0X124, 0X125, 0X127, 0X128, 0X130, 0X131, 0X133, 0X134, 0X136, 0X137, 0X139, 0X140, 0X142, 0X143: JUMPER-SMT_2_NO_SILK; SMT-JUMPER_2_NO_SILK
0X3, 0X6, 0X9, 0X12, 0X15, 0X18, 0X21, 0X24, 0X27, 0X30, 0X33, 0X36, 0X39, 0X42, 0X44, 0X48, 0X51, 0X54, 0X57, 0X60, 0X63, 0X66, 0X69, 0X72, 0X75, 0X78, 0X81, 0X84, 0X87, 0X90, 0X93, 0X96, 0X99, 0X102, 0X105, 0X108, 0X111, 0X114, 0X117, 0X120, 0X123, 0X126, 0X129, 0X132, 0X135, 0X138, 0X141, 0X144: JUMPER-SMT_2_NC_TRACE_SILK; SMT-JUMPER_2_NC_TRACE_SILK
C1, C2, C3, C4, C5, C6, C7, C8, C9, C10, C11, C12, C13, C14, C15, C16, C17, C18, C19, C20, C21, C22, C23, C24, C25, C26, C27, C28, C29, C30, C31, C32, C33, C34, C35, C36, C37, C38, C39, C40, C41, C42, C43, C44, C45, C46, C47, C48: 0.1uF; 0402-TIGHT
D1, D2, D3, D4, D5, D6, D7, D8, D9, D10, D11, D12, D13, D14, D15, D16, D17, D18, D19, D20, D21, D22, D23, D24, D25, D26, D27, D28, D29, D30, D31, D32, D33, D34, D35, D36, D37, D38, D39, D40, D41, D42, D43, D44, D45, D46, D47, D48: RED; LED-0603
E$1, E$2, E$3, E$4: FIDUCIAL-1X2
E$5, E$6: FIDUCIAL-1.5X3
FD1, FD2, FD3, FD4, FD5, FD6, FD7, FD8, FD9, FD10, FD11, FD12, FD13, FD14, FD15, FD16, FD17, FD18, FD19, FD20, FD21, FD22, FD23, FD24, FD25, FD26, FD27, FD28, FD29, FD30, FD31, FD32, FD33, FD34, FD35, FD36, FD37, FD38, FD39, FD40, FD41, FD42, FD43, FD44, FD45, FD46, FD47, FD48, FD49, FD50, FD51, FD52, FD53, FD54, FD55, FD56, FD57, FD58, FD59, FD60, FD61, FD62, FD63, FD64, FD65, FD66, FD67, FD68, FD69, FD70, FD71, FD72, FD73, FD74, FD75, FD76, FD77, FD78, FD79, FD80, FD81, FD82, FD83, FD84, FD85, FD86, FD87, FD88, FD89, FD90, FD91, FD92, FD93, FD94, FD95, FD96, FD97, FD98, FD99, FD100, FD101, FD102, FD103, FD104, FD105, FD106, FD107, FD108, FD109, FD110, FD111, FD112, FD113, FD114, FD115, FD116, FD117, FD118, FD119, FD120, FD121, FD122, FD123, FD124, FD125, FD126, FD127, FD128, FD129, FD130, FD131, FD132, FD133, FD134, FD135, FD136, FD137, FD138, FD139, FD140, FD141, FD142, FD143, FD144, FD145, FD146, FD147, FD148, FD149, FD150, FD151, FD152, FD153, FD154, FD155, FD156, FD157, FD158, FD159, FD160, FD161, FD162, FD163, FD164, FD165, FD166, FD167, FD168, FD169, FD170, FD171, FD172, FD173, FD174, FD175, FD176, FD177, FD178, FD179, FD180, FD181, FD182, FD183, FD184, FD185, FD186, FD187, FD188, FD189, FD190, FD191, FD192: FIDUCIALUFIDUCIAL; FIDUCIAL-MICRO
FRAME1, FRAME2, FRAME3, FRAME4, FRAME5, FRAME6, FRAME7, FRAME8, FRAME9, FRAME10, FRAME11, FRAME12, FRAME13, FRAME14, FRAME15, FRAME16, FRAME17, FRAME18, FRAME19, FRAME20, FRAME21, FRAME22, FRAME23, FRAME24, FRAME25, FRAME26, FRAME27, FRAME28, FRAME29, FRAME30, FRAME31, FRAME32, FRAME33, FRAME34, FRAME35, FRAME36, FRAME37, FRAME38, FRAME39, FRAME40, FRAME41, FRAME42, FRAME43, FRAME44, FRAME45, FRAME46, FRAME47, FRAME48: FRAME-LETTER; CREATIVE_COMMONS
H1, H2, H3, H4, H5, H6, H7, H8, H9, H10, H11, H12, H13, H14, H15, H16, H17, H18, H19, H20, H21, H22, H23, H24, H25, H26, H27, H28, H29, H30, H31, H32, H33, H34, H35, H36, H37, H38, H39, H40, H41, H42, H43, H44, H45, H46, H47, H48, H49, H50, H51, H52, H53, H54, H55, H56, H57, H58, H59, H60, H61, H62, H63, H64, H65, H66, H67, H68, H69, H70, H71, H72, H73, H74, H75, H76, H77, H78, H79, H80, H81, H82, H83, H84, H85, H86, H87, H88, H89, H90, H91, H92, H93, H94, H95, H96: STAND-OFFTIGHT; STAND-OFF-TIGHT
I2C_PU, I2C_PU1, I2C_PU2, I2C_PU3, I2C_PU4, I2C_PU5, I2C_PU6, I2C_PU7, I2C_PU8, I2C_PU9, I2C_PU10, I2C_PU11, I2C_PU12, I2C_PU13, I2C_PU14, I2C_PU15, I2C_PU16, I2C_PU17, I2C_PU18, I2C_PU19, I2C_PU20, I2C_PU21, I2C_PU22, I2C_PU23, I2C_PU24, I2C_PU25, I2C_PU26, I2C_PU27, I2C_PU28, I2C_PU29, I2C_PU30, I2C_PU31, I2C_PU32, I2C_PU33, I2C_PU34, I2C_PU35, I2C_PU36, I2C_PU37, I2C_PU38, I2C_PU39, I2C_PU40, I2C_PU41, I2C_PU42, I2C_PU43, I2C_PU44, I2C_PU45, I2C_PU46, I2C_PU47: S_MODE; SMT-JUMPER_3_2-NC_TRACE_SILK
J1, J6, J9, J12, J15, J18, J21, J24, J27, J30, J33, J36, J39, J42, J45, J48, J51, J54, J57, J60, J63, J66, J69, J72, J75, J78, J81, J84, J87, J90, J93, J96, J99, J102, J105, J108, J111, J114, J117, J120, J123, J126, J129, J132, J135, J138, J141, J144: 1X05_NO_SILK
J2, J3, J4, J5, J7, J8, J10, J11, J13, J14, J16, J17, J19, J20, J22, J23, J25, J26, J28, J29, J31, J32, J34, J35, J37, J38, J40, J41, J43, J44, J46, J47, J49, J50, J52, J53, J55, J56, J58, J59, J61, J62, J64, J65, J67, J68, J70, J71, J73, J74, J76, J77, J79, J80, J82, J83, J85, J86, J88, J89, J91, J92, J94, J95, J97, J98, J100, J101, J103, J104, J106, J107, J109, J110, J112, J113, J115, J116, J118, J119, J121, J122, J124, J125, J127, J128, J130, J131, J133, J134, J136, J137, J139, J140, J142, J143: QWIIC_RIGHT_ANGLE; JST04_1MM_RA
LED, LED1, LED2, LED3, LED4, LED5, LED6, LED7, LED8, LED9, LED10, LED11, LED12, LED13, LED14, LED15, LED16, LED17, LED18, LED19, LED20, LED21, LED22, LED23, LED24, LED25, LED26, LED27, LED28, LED29, LED30, LED31, LED32, LED33, LED34, LED35, LED36, LED37, LED38, LED39, LED40, LED41, LED42, LED43, LED44, LED45, LED46, LED47: JUMPER-SMT_2_NC_TRACE_SILK; SMT-JUMPER_2_NC_TRACE_SILK
LOGO1, LOGO4, LOGO7, LOGO10, LOGO13, LOGO16, LOGO19, LOGO22, LOGO25, LOGO28, LOGO31, LOGO34, LOGO37, LOGO40, LOGO43, LOGO46, LOGO49, LOGO52, LOGO55, LOGO58, LOGO61, LOGO64, LOGO67, LOGO70, LOGO73, LOGO76, LOGO79, LOGO82, LOGO85, LOGO88, LOGO91, LOGO94, LOGO97, LOGO100, LOGO103, LOGO106, LOGO109, LOGO112, LOGO115, LOGO118, LOGO121, LOGO124, LOGO127, LOGO130, LOGO133, LOGO136, LOGO139, LOGO142: SFE_LOGO_NAMEBLANK; BLANK
LOGO2, LOGO5, LOGO8, LOGO11, LOGO14, LOGO17, LOGO20, LOGO23, LOGO26, LOGO29, LOGO32, LOGO35, LOGO38, LOGO41, LOGO44, LOGO47, LOGO50, LOGO53, LOGO56, LOGO59, LOGO62, LOGO65, LOGO68, LOGO71, LOGO74, LOGO77, LOGO80, LOGO83, LOGO86, LOGO89, LOGO92, LOGO95, LOGO98, LOGO101, LOGO104, LOGO107, LOGO110, LOGO113, LOGO116, LOGO119, LOGO122, LOGO125, LOGO128, LOGO131, LOGO134, LOGO137, LOGO140, LOGO143: QWIIC_LOGO_3MM; QWIIC_3MM
LOGO3, LOGO6, LOGO9, LOGO12, LOGO15, LOGO18, LOGO21, LOGO24, LOGO27, LOGO30, LOGO33, LOGO36, LOGO39, LOGO42, LOGO45, LOGO48, LOGO51, LOGO54, LOGO57, LOGO60, LOGO63, LOGO66, LOGO69, LOGO72, LOGO75, LOGO78, LOGO81, LOGO84, LOGO87, LOGO90, LOGO93, LOGO96, LOGO99, LOGO102, LOGO105, LOGO108, LOGO111, LOGO114, LOGO117, LOGO120, LOGO123, LOGO126, LOGO129, LOGO132, LOGO135, LOGO138, LOGO141, LOGO144: OSHW-LOGONO_SILK; DUMMY
R1, R2, R3, R5, R11, R12, R16, R17, R21, R22, R26, R27, R31, R32, R36, R37, R41, R42, R46, R47, R51, R52, R56, R57, R61, R62, R66, R67, R71, R72, R76, R77, R81, R82, R86, R87, R91, R92, R96, R97, R101, R102, R106, R107, R111, R112, R116, R117, R121, R122, R126, R127, R131, R132, R136, R137, R141, R142, R146, R147, R151, R152, R156, R157, R161, R162, R166, R167, R171, R172, R176, R177, R181, R182, R186, R187, R191, R192, R196, R197, R201, R202, R206, R207, R211, R212, R216, R217, R221, R222, R226, R227, R231, R232, R236, R237: 2.2k; 0603
R4, R6, R13, R18, R23, R28, R33, R38, R43, R48, R53, R58, R63, R68, R73, R78, R83, R88, R93, R98, R103, R108, R113, R118, R123, R128, R133, R138, R143, R148, R153, R158, R163, R168, R173, R178, R183, R188, R193, R198, R203, R208, R213, R218, R223, R228, R233, R238: 4.7k; 0603
R7, R8, R9, R10, R14, R15, R19, R20, R24, R25, R29, R30, R34, R35, R39, R40, R44, R45, R49, R50, R54, R55, R59, R60, R64, R65, R69, R70, R74, R75, R79, R80, R84, R85, R89, R90, R94, R95, R99, R100, R104, R105, R109, R110, R114, R115, R119, R120, R124, R125, R129, R130, R134, R135, R139, R140, R144, R145, R149, R150, R154, R155, R159, R160, R164, R165, R169, R170, R174, R175, R179, R180, R184, R185, R189, R190, R194, R195, R199, R200, R204, R205, R209, R210, R214, R215, R219, R220, R224, R225, R229, R230, R234, R235, R239, R240: 10k; 0603
U1, U2, U3, U4, U5, U6, U7, U8, U9, U10, U11, U12, U13, U14, U15, U16, U17, U18, U19, U20, U21, U22, U23, U24, U25, U26, U27, U28, U29, U30, U31, U32, U33, U34, U35, U36, U37, U38, U39, U40, U41, U42, U43, U44, U45, U46, U47, U48: OPT4048; FCSOT
U$1, U$30, U$60, U$84, U$108, U$132, U$156, U$180, U$204, U$228, U$252, U$276, U$300, U$324, U$348, U$372, U$396, U$420, U$444, U$468, U$492, U$516, U$540, U$564, U$588, U$612, U$636, U$660, U$684, U$708, U$732, U$756, U$780, U$804, U$828, U$852, U$876, U$900, U$924, U$948, U$972, U$996, U$1020, U$1044, U$1068, U$1092, U$1116, U$1140: #INT#9
U$2, U$31, U$61, U$85, U$109, U$133, U$157, U$181, U$205, U$229, U$253, U$277, U$301, U$325, U$349, U$373, U$397, U$421, U$445, U$469, U$493, U$517, U$541, U$565, U$589, U$613, U$637, U$661, U$685, U$709, U$733, U$757, U$781, U$805, U$829, U$853, U$877, U$901, U$925, U$949, U$973, U$997, U$1021, U$1045, U$1069, U$1093, U$1117, U$1141: COLOR_SENSOR227
U$3, U$12, U$32, U$42, U$62, U$67, U$86, U$91, U$110, U$115, U$134, U$139, U$158, U$163, U$182, U$187, U$206, U$211, U$230, U$235, U$254, U$259, U$278, U$283, U$302, U$307, U$326, U$331, U$350, U$355, U$374, U$379, U$398, U$403, U$422, U$427, U$446, U$451, U$470, U$475, U$494, U$499, U$518, U$523, U$542, U$547, U$566, U$571, U$590, U$595, U$614, U$619, U$638, U$643, U$662, U$667, U$686, U$691, U$710, U$715, U$734, U$739, U$758, U$763, U$782, U$787, U$806, U$811, U$830, U$835, U$854, U$859, U$878, U$883, U$902, U$907, U$926, U$931, U$950, U$955, U$974, U$979, U$998, U$1003, U$1022, U$1027, U$1046, U$1051, U$1070, U$1075, U$1094, U$1099, U$1118, U$1123, U$1142, U$1147: OPT4048229
U$4, U$45, U$69, U$93, U$117, U$141, U$165, U$189, U$213, U$237, U$261, U$285, U$309, U$333, U$357, U$381, U$405, U$429, U$453, U$477, U$501, U$525, U$549, U$573, U$597, U$621, U$645, U$669, U$693, U$717, U$741, U$765, U$789, U$813, U$837, U$861, U$885, U$909, U$933, U$957, U$981, U$1005, U$1029, U$1053, U$1077, U$1101, U$1125, U$1149: #0X44#11
U$5, U$46, U$70, U$94, U$118, U$142, U$166, U$190, U$214, U$238, U$262, U$286, U$310, U$334, U$358, U$382, U$406, U$430, U$454, U$478, U$502, U$526, U$550, U$574, U$598, U$622, U$646, U$670, U$694, U$718, U$742, U$766, U$790, U$814, U$838, U$862, U$886, U$910, U$934, U$958, U$982, U$1006, U$1030, U$1054, U$1078, U$1102, U$1126, U$1150: #0X46#11
U$6, U$47, U$71, U$95, U$119, U$143, U$167, U$191, U$215, U$239, U$263, U$287, U$311, U$335, U$359, U$383, U$407, U$431, U$455, U$479, U$503, U$527, U$551, U$575, U$599, U$623, U$647, U$671, U$695, U$719, U$743, U$767, U$791, U$815, U$839, U$863, U$887, U$911, U$935, U$959, U$983, U$1007, U$1031, U$1055, U$1079, U$1103, U$1127, U$1151: #0X45#11
U$7, U$34, U$64, U$88, U$112, U$136, U$160, U$184, U$208, U$232, U$256, U$280, U$304, U$328, U$352, U$376, U$400, U$424, U$448, U$472, U$496, U$520, U$544, U$568, U$592, U$616, U$640, U$664, U$688, U$712, U$736, U$760, U$784, U$808, U$832, U$856, U$880, U$904, U$928, U$952, U$976, U$1000, U$1024, U$1048, U$1072, U$1096, U$1120, U$1144: #INT#3
U$8, U$33, U$63, U$87, U$111, U$135, U$159, U$183, U$207, U$231, U$255, U$279, U$303, U$327, U$351, U$375, U$399, U$423, U$447, U$471, U$495, U$519, U$543, U$567, U$591, U$615, U$639, U$663, U$687, U$711, U$735, U$759, U$783, U$807, U$831, U$855, U$879, U$903, U$927, U$951, U$975, U$999, U$1023, U$1047, U$1071, U$1095, U$1119, U$1143: SFE_LOGO_NAME_.1
U$9, U$36, U$65, U$89, U$113, U$137, U$161, U$185, U$209, U$233, U$257, U$281, U$305, U$329, U$353, U$377, U$401, U$425, U$449, U$473, U$497, U$521, U$545, U$569, U$593, U$617, U$641, U$665, U$689, U$713, U$737, U$761, U$785, U$809, U$833, U$857, U$881, U$905, U$929, U$953, U$977, U$1001, U$1025, U$1049, U$1073, U$1097, U$1121, U$1145: COLOR14
U$10, U$17, U$24, U$37, U$49, U$54, U$73, U$78, U$97, U$102, U$121, U$126, U$145, U$150, U$169, U$174, U$193, U$198, U$217, U$222, U$241, U$246, U$265, U$270, U$289, U$294, U$313, U$318, U$337, U$342, U$361, U$366, U$385, U$390, U$409, U$414, U$433, U$438, U$457, U$462, U$481, U$486, U$505, U$510, U$529, U$534, U$553, U$558, U$577, U$582, U$601, U$606, U$625, U$630, U$649, U$654, U$673, U$678, U$697, U$702, U$721, U$726, U$745, U$750, U$769, U$774, U$793, U$798, U$817, U$822, U$841, U$846, U$865, U$870, U$889, U$894, U$913, U$918, U$937, U$942, U$961, U$966, U$985, U$990, U$1009, U$1014, U$1033, U$1038, U$1057, U$1062, U$1081, U$1086, U$1105, U$1110, U$1129, U$1134: #3V3#0
U$11, U$41, U$66, U$90, U$114, U$138, U$162, U$186, U$210, U$234, U$258, U$282, U$306, U$330, U$354, U$378, U$402, U$426, U$450, U$474, U$498, U$522, U$546, U$570, U$594, U$618, U$642, U$666, U$690, U$714, U$738, U$762, U$786, U$810, U$834, U$858, U$882, U$906, U$930, U$954, U$978, U$1002, U$1026, U$1050, U$1074, U$1098, U$1122, U$1146: SENSOR15
U$13, U$44, U$68, U$92, U$116, U$140, U$164, U$188, U$212, U$236, U$260, U$284, U$308, U$332, U$356, U$380, U$404, U$428, U$452, U$476, U$500, U$524, U$548, U$572, U$596, U$620, U$644, U$668, U$692, U$716, U$740, U$764, U$788, U$812, U$836, U$860, U$884, U$908, U$932, U$956, U$980, U$1004, U$1028, U$1052, U$1076, U$1100, U$1124, U$1148: #SDA#1
U$14, U$48, U$72, U$96, U$120, U$144, U$168, U$192, U$216, U$240, U$264, U$288, U$312, U$336, U$360, U$384, U$408, U$432, U$456, U$480, U$504, U$528, U$552, U$576, U$600, U$624, U$648, U$672, U$696, U$720, U$744, U$768, U$792, U$816, U$840, U$864, U$888, U$912, U$936, U$960, U$984, U$1008, U$1032, U$1056, U$1080, U$1104, U$1128, U$1152: #LED#11
U$15, U$29, U$59, U$83, U$107, U$131, U$155, U$179, U$203, U$227, U$251, U$275, U$299, U$323, U$347, U$371, U$395, U$419, U$443, U$467, U$491, U$515, U$539, U$563, U$587, U$611, U$635, U$659, U$683, U$707, U$731, U$755, U$779, U$803, U$827, U$851, U$875, U$899, U$923, U$947, U$971, U$995, U$1019, U$1043, U$1067, U$1091, U$1115, U$1139: OSHW-LOGO-MINI
U$16, U$18, U$25, U$38, U$50, U$55, U$74, U$79, U$98, U$103, U$122, U$127, U$146, U$151, U$170, U$175, U$194, U$199, U$218, U$223, U$242, U$247, U$266, U$271, U$290, U$295, U$314, U$319, U$338, U$343, U$362, U$367, U$386, U$391, U$410, U$415, U$434, U$439, U$458, U$463, U$482, U$487, U$506, U$511, U$530, U$535, U$554, U$559, U$578, U$583, U$602, U$607, U$626, U$631, U$650, U$655, U$674, U$679, U$698, U$703, U$722, U$727, U$746, U$751, U$770, U$775, U$794, U$799, U$818, U$823, U$842, U$847, U$866, U$871, U$890, U$895, U$914, U$919, U$938, U$943, U$962, U$967, U$986, U$991, U$1010, U$1015, U$1034, U$1039, U$1058, U$1063, U$1082, U$1087, U$1106, U$1111, U$1130, U$1135: #GND#4
U$19, U$21, U$26, U$39, U$51, U$56, U$75, U$80, U$99, U$104, U$123, U$128, U$147, U$152, U$171, U$176, U$195, U$200, U$219, U$224, U$243, U$248, U$267, U$272, U$291, U$296, U$315, U$320, U$339, U$344, U$363, U$368, U$387, U$392, U$411, U$416, U$435, U$440, U$459, U$464, U$483, U$488, U$507, U$512, U$531, U$536, U$555, U$560, U$579, U$584, U$603, U$608, U$627, U$632, U$651, U$656, U$675, U$680, U$699, U$704, U$723, U$728, U$747, U$752, U$771, U$776, U$795, U$800, U$819, U$824, U$843, U$848, U$867, U$872, U$891, U$896, U$915, U$920, U$939, U$944, U$963, U$968, U$987, U$992, U$1011, U$1016, U$1035, U$1040, U$1059, U$1064, U$1083, U$1088, U$1107, U$1112, U$1131, U$1136: #SCL#5
U$20, U$22, U$52, U$76, U$100, U$124, U$148, U$172, U$196, U$220, U$244, U$268, U$292, U$316, U$340, U$364, U$388, U$412, U$436, U$460, U$484, U$508, U$532, U$556, U$580, U$604, U$628, U$652, U$676, U$700, U$724, U$748, U$772, U$796, U$820, U$844, U$868, U$892, U$916, U$940, U$964, U$988, U$1012, U$1036, U$1060, U$1084, U$1108, U$1132: #I2C#11
U$23, U$35, U$53, U$77, U$101, U$125, U$149, U$173, U$197, U$221, U$245, U$269, U$293, U$317, U$341, U$365, U$389, U$413, U$437, U$461, U$485, U$509, U$533, U$557, U$581, U$605, U$629, U$653, U$677, U$701, U$725, U$749, U$773, U$797, U$821, U$845, U$869, U$893, U$917, U$941, U$965, U$989, U$1013, U$1037, U$1061, U$1085, U$1109, U$1133: SFE_LOGO_FLAME_.1
U$27, U$40, U$57, U$81, U$105, U$129, U$153, U$177, U$201, U$225, U$249, U$273, U$297, U$321, U$345, U$369, U$393, U$417, U$441, U$465, U$489, U$513, U$537, U$561, U$585, U$609, U$633, U$657, U$681, U$705, U$729, U$753, U$777, U$801, U$825, U$849, U$873, U$897, U$921, U$945, U$969, U$993, U$1017, U$1041, U$1065, U$1089, U$1113, U$1137: #SDA#6
U$28, U$43, U$58, U$82, U$106, U$130, U$154, U$178, U$202, U$226, U$250, U$274, U$298, U$322, U$346, U$370, U$394, U$418, U$442, U$466, U$490, U$514, U$538, U$562, U$586, U$610, U$634, U$658, U$682, U$706, U$730, U$754, U$778, U$802, U$826, U$850, U$874, U$898, U$922, U$946, U$970, U$994, U$1018, U$1042, U$1066, U$1090, U$1114, U$1138: PWR8821882023

Connections:
3.3V: C2.1, I2C_PU.2, J1.2, J4.2, J5.2, R4.2, R7.2, R8.2, U1.P1
3.3V1: C1.1, I2C_PU1.2, J2.2, J3.2, J6.2, R6.2, R9.2, R10.2, U2.P1
3.3V2: C3.1, I2C_PU2.2, J7.2, J8.2, J9.2, R13.2, R14.2, R15.2, U3.P1
3.3V3: C4.1, I2C_PU3.2, J10.2, J11.2, J12.2, R18.2, R19.2, R20.2, U4.P1
3.3V4: C5.1, I2C_PU4.2, J13.2, J14.2, J15.2, R23.2, R24.2, R25.2, U5.P1
3.3V5: C6.1, I2C_PU5.2, J16.2, J17.2, J18.2, R28.2, R29.2, R30.2, U6.P1
3.3V6: C7.1, I2C_PU6.2, J19.2, J20.2, J21.2, R33.2, R34.2, R35.2, U7.P1
3.3V7: C8.1, I2C_PU7.2, J22.2, J23.2, J24.2, R38.2, R39.2, R40.2, U8.P1
3.3V8: C9.1, I2C_PU8.2, J25.2, J26.2, J27.2, R43.2, R44.2, R45.2, U9.P1
3.3V9: C10.1, I2C_PU9.2, J28.2, J29.2, J30.2, R48.2, R49.2, R50.2, U10.P1
3.3V10: C11.1, I2C_PU10.2, J31.2, J32.2, J33.2, R53.2, R54.2, R55.2, U11.P1
3.3V11: C12.1, I2C_PU11.2, J34.2, J35.2, J36.2, R58.2, R59.2, R60.2, U12.P1
3.3V12: C13.1, I2C_PU12.2, J37.2, J38.2, J39.2, R63.2, R64.2, R65.2, U13.P1
3.3V13: C14.1, I2C_PU13.2, J40.2, J41.2, J42.2, R68.2, R69.2, R70.2, U14.P1
3.3V14: C15.1, I2C_PU14.2, J43.2, J44.2, J45.2, R73.2, R74.2, R75.2, U15.P1
3.3V15: C16.1, I2C_PU15.2, J46.2, J47.2, J48.2, R78.2, R79.2, R80.2, U16.P1
3.3V16: C17.1, I2C_PU16.2, J49.2, J50.2, J51.2, R83.2, R84.2, R85.2, U17.P1
3.3V17: C18.1, I2C_PU17.2, J52.2, J53.2, J54.2, R88.2, R89.2, R90.2, U18.P1
3.3V18: C19.1, I2C_PU18.2, J55.2, J56.2, J57.2, R93.2, R94.2, R95.2, U19.P1
3.3V19: C20.1, I2C_PU19.2, J58.2, J59.2, J60.2, R98.2, R99.2, R100.2, U20.P1
3.3V20: C21.1, I2C_PU20.2, J61.2, J62.2, J63.2, R103.2, R104.2, R105.2, U21.P1
3.3V21: C22.1, I2C_PU21.2, J64.2, J65.2, J66.2, R108.2, R109.2, R110.2, U22.P1
3.3V22: C23.1, I2C_PU22.2, J67.2, J68.2, J69.2, R113.2, R114.2, R115.2, U23.P1
3.3V23: C24.1, I2C_PU23.2, J70.2, J71.2, J72.2, R118.2, R119.2, R120.2, U24.P1
3.3V24: C25.1, I2C_PU24.2, J73.2, J74.2, J75.2, R123.2, R124.2, R125.2, U25.P1
3.3V25: C26.1, I2C_PU25.2, J76.2, J77.2, J78.2, R128.2, R129.2, R130.2, U26.P1
3.3V26: C27.1, I2C_PU26.2, J79.2, J80.2, J81.2, R133.2, R134.2, R135.2, U27.P1
3.3V27: C28.1, I2C_PU27.2, J82.2, J83.2, J84.2, R138.2, R139.2, R140.2, U28.P1
3.3V28: C29.1, I2C_PU28.2, J85.2, J86.2, J87.2, R143.2, R144.2, R145.2, U29.P1
3.3V29: C30.1, I2C_PU29.2, J88.2, J89.2, J90.2, R148.2, R149.2, R150.2, U30.P1
3.3V30: C31.1, I2C_PU30.2, J91.2, J92.2, J93.2, R153.2, R154.2, R155.2, U31.P1
3.3V31: C32.1, I2C_PU31.2, J94.2, J95.2, J96.2, R158.2, R159.2, R160.2, U32.P1
3.3V32: C33.1, I2C_PU32.2, J97.2, J98.2, J99.2, R163.2, R164.2, R165.2, U33.P1
3.3V33: C34.1, I2C_PU33.2, J100.2, J101.2, J102.2, R168.2, R169.2, R170.2, U34.P1
3.3V34: C35.1, I2C_PU34.2, J103.2, J104.2, J105.2, R173.2, R174.2, R175.2, U35.P1
3.3V35: C36.1, I2C_PU35.2, J106.2, J107.2, J108.2, R178.2, R179.2, R180.2, U36.P1
3.3V36: C37.1, I2C_PU36.2, J109.2, J110.2, J111.2, R183.2, R184.2, R185.2, U37.P1
3.3V37: C38.1, I2C_PU37.2, J112.2, J113.2, J114.2, R188.2, R189.2, R190.2, U38.P1
3.3V38: C39.1, I2C_PU38.2, J115.2, J116.2, J117.2, R193.2, R194.2, R195.2, U39.P1
3.3V39: C40.1, I2C_PU39.2, J118.2, J119.2, J120.2, R198.2, R199.2, R200.2, U40.P1
3.3V40: C41.1, I2C_PU40.2, J121.2, J122.2, J123.2, R203.2, R204.2, R205.2, U41.P1
3.3V41: C42.1, I2C_PU41.2, J124.2, J125.2, J126.2, R208.2, R209.2, R210.2, U42.P1
3.3V42: C43.1, I2C_PU42.2, J127.2, J128.2, J129.2, R213.2, R214.2, R215.2, U43.P1
3.3V43: C44.1, I2C_PU43.2, J130.2, J131.2, J132.2, R218.2, R219.2, R220.2, U44.P1
3.3V44: C45.1, I2C_PU44.2, J133.2, J134.2, J135.2, R223.2, R224.2, R225.2, U45.P1
3.3V45: C46.1, I2C_PU45.2, J136.2, J137.2, J138.2, R228.2, R229.2, R230.2, U46.P1
3.3V46: C47.1, I2C_PU46.2, J139.2, J140.2, J141.2, R233.2, R234.2, R235.2, U47.P1
3.3V47: C48.1, I2C_PU47.2, J142.2, J143.2, J144.2, R238.2, R239.2, R240.2, U48.P1
ADDR: 0X44.1, 0X45.1, 0X46.1, U1.P2
ADDR1: 0X1.1, 0X2.1, 0X3.1, U2.P2
ADDR2: 0X4.1, 0X5.1, 0X6.1, U3.P2
ADDR3: 0X7.1, 0X8.1, 0X9.1, U4.P2
ADDR4: 0X10.1, 0X11.1, 0X12.1, U5.P2
ADDR5: 0X13.1, 0X14.1, 0X15.1, U6.P2
ADDR6: 0X16.1, 0X17.1, 0X18.1, U7.P2
ADDR7: 0X19.1, 0X20.1, 0X21.1, U8.P2
ADDR8: 0X22.1, 0X23.1, 0X24.1, U9.P2
ADDR9: 0X25.1, 0X26.1, 0X27.1, U10.P2
ADDR10: 0X28.1, 0X29.1, 0X30.1, U11.P2
ADDR11: 0X31.1, 0X32.1, 0X33.1, U12.P2
ADDR12: 0X34.1, 0X35.1, 0X36.1, U13.P2
ADDR13: 0X37.1, 0X38.1, 0X39.1, U14.P2
ADDR14: 0X40.1, 0X41.1, 0X42.1, U15.P2
ADDR15: 0X43.1, 0X47.1, 0X48.1, U16.P2
ADDR16: 0X49.1, 0X50.1, 0X51.1, U17.P2
ADDR17: 0X52.1, 0X53.1, 0X54.1, U18.P2
ADDR18: 0X55.1, 0X56.1, 0X57.1, U19.P2
ADDR19: 0X58.1, 0X59.1, 0X60.1, U20.P2
ADDR20: 0X61.1, 0X62.1, 0X63.1, U21.P2
ADDR21: 0X64.1, 0X65.1, 0X66.1, U22.P2
ADDR22: 0X67.1, 0X68.1, 0X69.1, U23.P2
ADDR23: 0X70.1, 0X71.1, 0X72.1, U24.P2
ADDR24: 0X73.1, 0X74.1, 0X75.1, U25.P2
ADDR25: 0X76.1, 0X77.1, 0X78.1, U26.P2
ADDR26: 0X79.1, 0X80.1, 0X81.1, U27.P2
ADDR27: 0X82.1, 0X83.1, 0X84.1, U28.P2
ADDR28: 0X85.1, 0X86.1, 0X87.1, U29.P2
ADDR29: 0X88.1, 0X89.1, 0X90.1, U30.P2
ADDR30: 0X91.1, 0X92.1, 0X93.1, U31.P2
ADDR31: 0X94.1, 0X95.1, 0X96.1, U32.P2
ADDR32: 0X97.1, 0X98.1, 0X99.1, U33.P2
ADDR33: 0X100.1, 0X101.1, 0X102.1, U34.P2
ADDR34: 0X103.1, 0X104.1, 0X105.1, U35.P2
ADDR35: 0X106.1, 0X107.1, 0X108.1, U36.P2
ADDR36: 0X109.1, 0X110.1, 0X111.1, U37.P2
ADDR37: 0X112.1, 0X113.1, 0X114.1, U38.P2
ADDR38: 0X115.1, 0X116.1, 0X117.1, U39.P2
ADDR39: 0X118.1, 0X119.1, 0X120.1, U40.P2
ADDR40: 0X121.1, 0X122.1, 0X123.1, U41.P2
ADDR41: 0X124.1, 0X125.1, 0X126.1, U42.P2
ADDR42: 0X127.1, 0X128.1, 0X129.1, U43.P2
ADDR43: 0X130.1, 0X131.1, 0X132.1, U44.P2
ADDR44: 0X133.1, 0X134.1, 0X135.1, U45.P2
ADDR45: 0X136.1, 0X137.1, 0X138.1, U46.P2
ADDR46: 0X139.1, 0X140.1, 0X141.1, U47.P2
ADDR47: 0X142.1, 0X143.1, 0X144.1, U48.P2
GND: 0X44.2, C2.2, J1.1, J4.1, J5.1, LED.1, U1.P4
GND1: 0X3.2, C1.2, J2.1, J3.1, J6.1, LED1.1, U2.P4
GND2: 0X6.2, C3.2, J7.1, J8.1, J9.1, LED2.1, U3.P4
GND3: 0X9.2, C4.2, J10.1, J11.1, J12.1, LED3.1, U4.P4
GND4: 0X12.2, C5.2, J13.1, J14.1, J15.1, LED4.1, U5.P4
GND5: 0X15.2, C6.2, J16.1, J17.1, J18.1, LED5.1, U6.P4
GND6: 0X18.2, C7.2, J19.1, J20.1, J21.1, LED6.1, U7.P4
GND7: 0X21.2, C8.2, J22.1, J23.1, J24.1, LED7.1, U8.P4
GND8: 0X24.2, C9.2, J25.1, J26.1, J27.1, LED8.1, U9.P4
GND9: 0X27.2, C10.2, J28.1, J29.1, J30.1, LED9.1, U10.P4
GND10: 0X30.2, C11.2, J31.1, J32.1, J33.1, LED10.1, U11.P4
GND11: 0X33.2, C12.2, J34.1, J35.1, J36.1, LED11.1, U12.P4
GND12: 0X36.2, C13.2, J37.1, J38.1, J39.1, LED12.1, U13.P4
GND13: 0X39.2, C14.2, J40.1, J41.1, J42.1, LED13.1, U14.P4
GND14: 0X42.2, C15.2, J43.1, J44.1, J45.1, LED14.1, U15.P4
GND15: 0X48.2, C16.2, J46.1, J47.1, J48.1, LED15.1, U16.P4
GND16: 0X51.2, C17.2, J49.1, J50.1, J51.1, LED16.1, U17.P4
GND17: 0X54.2, C18.2, J52.1, J53.1, J54.1, LED17.1, U18.P4
GND18: 0X57.2, C19.2, J55.1, J56.1, J57.1, LED18.1, U19.P4
GND19: 0X60.2, C20.2, J58.1, J59.1, J60.1, LED19.1, U20.P4
GND20: 0X63.2, C21.2, J61.1, J62.1, J63.1, LED20.1, U21.P4
GND21: 0X66.2, C22.2, J64.1, J65.1, J66.1, LED21.1, U22.P4
GND22: 0X69.2, C23.2, J67.1, J68.1, J69.1, LED22.1, U23.P4
GND23: 0X72.2, C24.2, J70.1, J71.1, J72.1, LED23.1, U24.P4
GND24: 0X75.2, C25.2, J73.1, J74.1, J75.1, LED24.1, U25.P4
GND25: 0X78.2, C26.2, J76.1, J77.1, J78.1, LED25.1, U26.P4
GND26: 0X81.2, C27.2, J79.1, J80.1, J81.1, LED26.1, U27.P4
GND27: 0X84.2, C28.2, J82.1, J83.1, J84.1, LED27.1, U28.P4
GND28: 0X87.2, C29.2, J85.1, J86.1, J87.1, LED28.1, U29.P4
GND29: 0X90.2, C30.2, J88.1, J89.1, J90.1, LED29.1, U30.P4
GND30: 0X93.2, C31.2, J91.1, J92.1, J93.1, LED30.1, U31.P4
GND31: 0X96.2, C32.2, J94.1, J95.1, J96.1, LED31.1, U32.P4
GND32: 0X99.2, C33.2, J97.1, J98.1, J99.1, LED32.1, U33.P4
GND33: 0X102.2, C34.2, J100.1, J101.1, J102.1, LED33.1, U34.P4
GND34: 0X105.2, C35.2, J103.1, J104.1, J105.1, LED34.1, U35.P4
GND35: 0X108.2, C36.2, J106.1, J107.1, J108.1, LED35.1, U36.P4
GND36: 0X111.2, C37.2, J109.1, J110.1, J111.1, LED36.1, U37.P4
GND37: 0X114.2, C38.2, J112.1, J113.1, J114.1, LED37.1, U38.P4
GND38: 0X117.2, C39.2, J115.1, J116.1, J117.1, LED38.1, U39.P4
GND39: 0X120.2, C40.2, J118.1, J119.1, J120.1, LED39.1, U40.P4
GND40: 0X123.2, C41.2, J121.1, J122.1, J123.1, LED40.1, U41.P4
GND41: 0X126.2, C42.2, J124.1, J125.1, J126.1, LED41.1, U42.P4
GND42: 0X129.2, C43.2, J127.1, J128.1, J129.1, LED42.1, U43.P4
GND43: 0X132.2, C44.2, J130.1, J131.1, J132.1, LED43.1, U44.P4
GND44: 0X135.2, C45.2, J133.1, J134.1, J135.1, LED44.1, U45.P4
GND45: 0X138.2, C46.2, J136.1, J137.1, J138.1, LED45.1, U46.P4
GND46: 0X141.2, C47.2, J139.1, J140.1, J141.1, LED46.1, U47.P4
GND47: 0X144.2, C48.2, J142.1, J143.1, J144.1, LED47.1, U48.P4
INT: J1.5, R7.1, U1.P7
INT1: J6.5, R9.1, U2.P7
INT2: J9.5, R14.1, U3.P7
INT3: J12.5, R19.1, U4.P7
INT4: J15.5, R24.1, U5.P7
INT5: J18.5, R29.1, U6.P7
INT6: J21.5, R34.1, U7.P7
INT7: J24.5, R39.1, U8.P7
INT8: J27.5, R44.1, U9.P7
INT9: J30.5, R49.1, U10.P7
INT10: J33.5, R54.1, U11.P7
INT11: J36.5, R59.1, U12.P7
INT12: J39.5, R64.1, U13.P7
INT13: J42.5, R69.1, U14.P7
INT14: J45.5, R74.1, U15.P7
INT15: J48.5, R79.1, U16.P7
INT16: J51.5, R84.1, U17.P7
INT17: J54.5, R89.1, U18.P7
INT18: J57.5, R94.1, U19.P7
INT19: J60.5, R99.1, U20.P7
INT20: J63.5, R104.1, U21.P7
INT21: J66.5, R109.1, U22.P7
INT22: J69.5, R114.1, U23.P7
INT23: J72.5, R119.1, U24.P7
INT24: J75.5, R124.1, U25.P7
INT25: J78.5, R129.1, U26.P7
INT26: J81.5, R134.1, U27.P7
INT27: J84.5, R139.1, U28.P7
INT28: J87.5, R144.1, U29.P7
INT29: J90.5, R149.1, U30.P7
INT30: J93.5, R154.1, U31.P7
INT31: J96.5, R159.1, U32.P7
INT32: J99.5, R164.1, U33.P7
INT33: J102.5, R169.1, U34.P7
INT34: J105.5, R174.1, U35.P7
INT35: J108.5, R179.1, U36.P7
INT36: J111.5, R184.1, U37.P7
INT37: J114.5, R189.1, U38.P7
INT38: J117.5, R194.1, U39.P7
INT39: J120.5, R199.1, U40.P7
INT40: J123.5, R204.1, U41.P7
INT41: J126.5, R209.1, U42.P7
INT42: J129.5, R214.1, U43.P7
INT43: J132.5, R219.1, U44.P7
INT44: J135.5, R224.1, U45.P7
INT45: J138.5, R229.1, U46.P7
INT46: J141.5, R234.1, U47.P7
INT47: J144.5, R239.1, U48.P7
unnamed: I2C_PU.1, R1.2
unnamed: I2C_PU.3, R2.2
unnamed: D1.A, R4.1
unnamed: D1.C, LED.2
unnamed: I2C_PU1.1, R3.2
unnamed: I2C_PU1.3, R5.2
unnamed: D2.A, R6.1
unnamed: D2.C, LED1.2
unnamed: 0X45.2, R8.1
unnamed: 0X2.2, R10.1
unnamed: I2C_PU2.1, R11.2
unnamed: I2C_PU2.3, R12.2
unnamed: D3.A, R13.1
unnamed: D3.C, LED2.2
unnamed: 0X5.2, R15.1
unnamed: I2C_PU3.1, R16.2
unnamed: I2C_PU3.3, R17.2
unnamed: D4.A, R18.1
unnamed: D4.C, LED3.2
unnamed: 0X8.2, R20.1
unnamed: I2C_PU4.1, R21.2
unnamed: I2C_PU4.3, R22.2
unnamed: D5.A, R23.1
unnamed: D5.C, LED4.2
unnamed: 0X11.2, R25.1
unnamed: I2C_PU5.1, R26.2
unnamed: I2C_PU5.3, R27.2
unnamed: D6.A, R28.1
unnamed: D6.C, LED5.2
unnamed: 0X14.2, R30.1
unnamed: I2C_PU6.1, R31.2
unnamed: I2C_PU6.3, R32.2
unnamed: D7.A, R33.1
unnamed: D7.C, LED6.2
unnamed: 0X17.2, R35.1
unnamed: I2C_PU7.1, R36.2
unnamed: I2C_PU7.3, R37.2
unnamed: D8.A, R38.1
unnamed: D8.C, LED7.2
unnamed: 0X20.2, R40.1
unnamed: I2C_PU8.1, R41.2
unnamed: I2C_PU8.3, R42.2
unnamed: D9.A, R43.1
unnamed: D9.C, LED8.2
unnamed: 0X23.2, R45.1
unnamed: I2C_PU9.1, R46.2
unnamed: I2C_PU9.3, R47.2
unnamed: D10.A, R48.1
unnamed: D10.C, LED9.2
unnamed: 0X26.2, R50.1
unnamed: I2C_PU10.1, R51.2
unnamed: I2C_PU10.3, R52.2
unnamed: D11.A, R53.1
unnamed: D11.C, LED10.2
unnamed: 0X29.2, R55.1
unnamed: I2C_PU11.1, R56.2
unnamed: I2C_PU11.3, R57.2
unnamed: D12.A, R58.1
unnamed: D12.C, LED11.2
unnamed: 0X32.2, R60.1
unnamed: I2C_PU12.1, R61.2
unnamed: I2C_PU12.3, R62.2
unnamed: D13.A, R63.1
unnamed: D13.C, LED12.2
unnamed: 0X35.2, R65.1
unnamed: I2C_PU13.1, R66.2
unnamed: I2C_PU13.3, R67.2
unnamed: D14.A, R68.1
unnamed: D14.C, LED13.2
unnamed: 0X38.2, R70.1
unnamed: I2C_PU14.1, R71.2
unnamed: I2C_PU14.3, R72.2
unnamed: D15.A, R73.1
unnamed: D15.C, LED14.2
unnamed: 0X41.2, R75.1
unnamed: I2C_PU15.1, R76.2
unnamed: I2C_PU15.3, R77.2
unnamed: D16.A, R78.1
unnamed: D16.C, LED15.2
unnamed: 0X47.2, R80.1
unnamed: I2C_PU16.1, R81.2
unnamed: I2C_PU16.3, R82.2
unnamed: D17.A, R83.1
unnamed: D17.C, LED16.2
unnamed: 0X50.2, R85.1
unnamed: I2C_PU17.1, R86.2
unnamed: I2C_PU17.3, R87.2
unnamed: D18.A, R88.1
unnamed: D18.C, LED17.2
unnamed: 0X53.2, R90.1
unnamed: I2C_PU18.1, R91.2
unnamed: I2C_PU18.3, R92.2
unnamed: D19.A, R93.1
unnamed: D19.C, LED18.2
unnamed: 0X56.2, R95.1
unnamed: I2C_PU19.1, R96.2
unnamed: I2C_PU19.3, R97.2
unnamed: D20.A, R98.1
unnamed: D20.C, LED19.2
unnamed: 0X59.2, R100.1
unnamed: I2C_PU20.1, R101.2
unnamed: I2C_PU20.3, R102.2
unnamed: D21.A, R103.1
unnamed: D21.C, LED20.2
unnamed: 0X62.2, R105.1
unnamed: I2C_PU21.1, R106.2
unnamed: I2C_PU21.3, R107.2
unnamed: D22.A, R108.1
unnamed: D22.C, LED21.2
unnamed: 0X65.2, R110.1
unnamed: I2C_PU22.1, R111.2
unnamed: I2C_PU22.3, R112.2
unnamed: D23.A, R113.1
unnamed: D23.C, LED22.2
unnamed: 0X68.2, R115.1
unnamed: I2C_PU23.1, R116.2
unnamed: I2C_PU23.3, R117.2
unnamed: D24.A, R118.1
unnamed: D24.C, LED23.2
unnamed: 0X71.2, R120.1
unnamed: I2C_PU24.1, R121.2
unnamed: I2C_PU24.3, R122.2
unnamed: D25.A, R123.1
unnamed: D25.C, LED24.2
unnamed: 0X74.2, R125.1
unnamed: I2C_PU25.1, R126.2
unnamed: I2C_PU25.3, R127.2
unnamed: D26.A, R128.1
unnamed: D26.C, LED25.2
unnamed: 0X77.2, R130.1
unnamed: I2C_PU26.1, R131.2
unnamed: I2C_PU26.3, R132.2
unnamed: D27.A, R133.1
unnamed: D27.C, LED26.2
unnamed: 0X80.2, R135.1
unnamed: I2C_PU27.1, R136.2
unnamed: I2C_PU27.3, R137.2
unnamed: D28.A, R138.1
unnamed: D28.C, LED27.2
unnamed: 0X83.2, R140.1
unnamed: I2C_PU28.1, R141.2
unnamed: I2C_PU28.3, R142.2
unnamed: D29.A, R143.1
unnamed: D29.C, LED28.2
unnamed: 0X86.2, R145.1
unnamed: I2C_PU29.1, R146.2
unnamed: I2C_PU29.3, R147.2
unnamed: D30.A, R148.1
unnamed: D30.C, LED29.2
unnamed: 0X89.2, R150.1
unnamed: I2C_PU30.1, R151.2
unnamed: I2C_PU30.3, R152.2
unnamed: D31.A, R153.1
unnamed: D31.C, LED30.2
unnamed: 0X92.2, R155.1
unnamed: I2C_PU31.1, R156.2
unnamed: I2C_PU31.3, R157.2
unnamed: D32.A, R158.1
unnamed: D32.C, LED31.2
unnamed: 0X95.2, R160.1
unnamed: I2C_PU32.1, R161.2
unnamed: I2C_PU32.3, R162.2
unnamed: D33.A, R163.1
unnamed: D33.C, LED32.2
unnamed: 0X98.2, R165.1
unnamed: I2C_PU33.1, R166.2
unnamed: I2C_PU33.3, R167.2
unnamed: D34.A, R168.1
unnamed: D34.C, LED33.2
unnamed: 0X101.2, R170.1
unnamed: I2C_PU34.1, R171.2
unnamed: I2C_PU34.3, R172.2
unnamed: D35.A, R173.1
unnamed: D35.C, LED34.2
unnamed: 0X104.2, R175.1
unnamed: I2C_PU35.1, R176.2
unnamed: I2C_PU35.3, R177.2
unnamed: D36.A, R178.1
unnamed: D36.C, LED35.2
unnamed: 0X107.2, R180.1
unnamed: I2C_PU36.1, R181.2
unnamed: I2C_PU36.3, R182.2
unnamed: D37.A, R183.1
unnamed: D37.C, LED36.2
unnamed: 0X110.2, R185.1
unnamed: I2C_PU37.1, R186.2
unnamed: I2C_PU37.3, R187.2
unnamed: D38.A, R188.1
unnamed: D38.C, LED37.2
unnamed: 0X113.2, R190.1
unnamed: I2C_PU38.1, R191.2
unnamed: I2C_PU38.3, R192.2
unnamed: D39.A, R193.1
unnamed: D39.C, LED38.2
unnamed: 0X116.2, R195.1
unnamed: I2C_PU39.1, R196.2
unnamed: I2C_PU39.3, R197.2
unnamed: D40.A, R198.1
unnamed: D40.C, LED39.2
unnamed: 0X119.2, R200.1
unnamed: I2C_PU40.1, R201.2
unnamed: I2C_PU40.3, R202.2
unnamed: D41.A, R203.1
unnamed: D41.C, LED40.2
unnamed: 0X122.2, R205.1
unnamed: I2C_PU41.1, R206.2
unnamed: I2C_PU41.3, R207.2
unnamed: D42.A, R208.1
unnamed: D42.C, LED41.2
unnamed: 0X125.2, R210.1
unnamed: I2C_PU42.1, R211.2
unnamed: I2C_PU42.3, R212.2
unnamed: D43.A, R213.1
unnamed: D43.C, LED42.2
unnamed: 0X128.2, R215.1
unnamed: I2C_PU43.1, R216.2
unnamed: I2C_PU43.3, R217.2
unnamed: D44.A, R218.1
unnamed: D44.C, LED43.2
unnamed: 0X131.2, R220.1
unnamed: I2C_PU44.1, R221.2
unnamed: I2C_PU44.3, R222.2
unnamed: D45.A, R223.1
unnamed: D45.C, LED44.2
unnamed: 0X134.2, R225.1
unnamed: I2C_PU45.1, R226.2
unnamed: I2C_PU45.3, R227.2
unnamed: D46.A, R228.1
unnamed: D46.C, LED45.2
unnamed: 0X137.2, R230.1
unnamed: I2C_PU46.1, R231.2
unnamed: I2C_PU46.3, R232.2
unnamed: D47.A, R233.1
unnamed: D47.C, LED46.2
unnamed: 0X140.2, R235.1
unnamed: I2C_PU47.1, R236.2
unnamed: I2C_PU47.3, R237.2
unnamed: D48.A, R238.1
unnamed: D48.C, LED47.2
unnamed: 0X143.2, R240.1
SCL: J1.4, J4.4, J5.4, R1.1, U1.P5
SCL1: J2.4, J3.4, J6.4, R3.1, U2.P5
SCL2: J7.4, J8.4, J9.4, R11.1, U3.P5
SCL3: J10.4, J11.4, J12.4, R16.1, U4.P5
SCL4: J13.4, J14.4, J15.4, R21.1, U5.P5
SCL5: J16.4, J17.4, J18.4, R26.1, U6.P5
SCL6: J19.4, J20.4, J21.4, R31.1, U7.P5
SCL7: J22.4, J23.4, J24.4, R36.1, U8.P5
SCL8: J25.4, J26.4, J27.4, R41.1, U9.P5
SCL9: J28.4, J29.4, J30.4, R46.1, U10.P5
SCL10: J31.4, J32.4, J33.4, R51.1, U11.P5
SCL11: J34.4, J35.4, J36.4, R56.1, U12.P5
SCL12: J37.4, J38.4, J39.4, R61.1, U13.P5
SCL13: J40.4, J41.4, J42.4, R66.1, U14.P5
SCL14: J43.4, J44.4, J45.4, R71.1, U15.P5
SCL15: J46.4, J47.4, J48.4, R76.1, U16.P5
SCL16: J49.4, J50.4, J51.4, R81.1, U17.P5
SCL17: J52.4, J53.4, J54.4, R86.1, U18.P5
SCL18: J55.4, J56.4, J57.4, R91.1, U19.P5
SCL19: J58.4, J59.4, J60.4, R96.1, U20.P5
SCL20: J61.4, J62.4, J63.4, R101.1, U21.P5
SCL21: J64.4, J65.4, J66.4, R106.1, U22.P5
SCL22: J67.4, J68.4, J69.4, R111.1, U23.P5
SCL23: J70.4, J71.4, J72.4, R116.1, U24.P5
SCL24: J73.4, J74.4, J75.4, R121.1, U25.P5
SCL25: J76.4, J77.4, J78.4, R126.1, U26.P5
SCL26: J79.4, J80.4, J81.4, R131.1, U27.P5
SCL27: J82.4, J83.4, J84.4, R136.1, U28.P5
SCL28: J85.4, J86.4, J87.4, R141.1, U29.P5
SCL29: J88.4, J89.4, J90.4, R146.1, U30.P5
SCL30: J91.4, J92.4, J93.4, R151.1, U31.P5
SCL31: J94.4, J95.4, J96.4, R156.1, U32.P5
SCL32: J97.4, J98.4, J99.4, R161.1, U33.P5
SCL33: J100.4, J101.4, J102.4, R166.1, U34.P5
SCL34: J103.4, J104.4, J105.4, R171.1, U35.P5
SCL35: J106.4, J107.4, J108.4, R176.1, U36.P5
SCL36: J109.4, J110.4, J111.4, R181.1, U37.P5
SCL37: J112.4, J113.4, J114.4, R186.1, U38.P5
SCL38: J115.4, J116.4, J117.4, R191.1, U39.P5
SCL39: J118.4, J119.4, J120.4, R196.1, U40.P5
SCL40: J121.4, J122.4, J123.4, R201.1, U41.P5
SCL41: J124.4, J125.4, J126.4, R206.1, U42.P5
SCL42: J127.4, J128.4, J129.4, R211.1, U43.P5
SCL43: J130.4, J131.4, J132.4, R216.1, U44.P5
SCL44: J133.4, J134.4, J135.4, R221.1, U45.P5
SCL45: J136.4, J137.4, J138.4, R226.1, U46.P5
SCL46: J139.4, J140.4, J141.4, R231.1, U47.P5
SCL47: J142.4, J143.4, J144.4, R236.1, U48.P5
SDA: 0X46.2, J1.3, J4.3, J5.3, R2.1, U1.P8
SDA1: 0X1.2, J2.3, J3.3, J6.3, R5.1, U2.P8
SDA2: 0X4.2, J7.3, J8.3, J9.3, R12.1, U3.P8
SDA3: 0X7.2, J10.3, J11.3, J12.3, R17.1, U4.P8
SDA4: 0X10.2, J13.3, J14.3, J15.3, R22.1, U5.P8
SDA5: 0X13.2, J16.3, J17.3, J18.3, R27.1, U6.P8
SDA6: 0X16.2, J19.3, J20.3, J21.3, R32.1, U7.P8
SDA7: 0X19.2, J22.3, J23.3, J24.3, R37.1, U8.P8
SDA8: 0X22.2, J25.3, J26.3, J27.3, R42.1, U9.P8
SDA9: 0X25.2, J28.3, J29.3, J30.3, R47.1, U10.P8
SDA10: 0X28.2, J31.3, J32.3, J33.3, R52.1, U11.P8
SDA11: 0X31.2, J34.3, J35.3, J36.3, R57.1, U12.P8
SDA12: 0X34.2, J37.3, J38.3, J39.3, R62.1, U13.P8
SDA13: 0X37.2, J40.3, J41.3, J42.3, R67.1, U14.P8
SDA14: 0X40.2, J43.3, J44.3, J45.3, R72.1, U15.P8
SDA15: 0X43.2, J46.3, J47.3, J48.3, R77.1, U16.P8
SDA16: 0X49.2, J49.3, J50.3, J51.3, R82.1, U17.P8
SDA17: 0X52.2, J52.3, J53.3, J54.3, R87.1, U18.P8
SDA18: 0X55.2, J55.3, J56.3, J57.3, R92.1, U19.P8
SDA19: 0X58.2, J58.3, J59.3, J60.3, R97.1, U20.P8
SDA20: 0X61.2, J61.3, J62.3, J63.3, R102.1, U21.P8
SDA21: 0X64.2, J64.3, J65.3, J66.3, R107.1, U22.P8
SDA22: 0X67.2, J67.3, J68.3, J69.3, R112.1, U23.P8
SDA23: 0X70.2, J70.3, J71.3, J72.3, R117.1, U24.P8
SDA24: 0X73.2, J73.3, J74.3, J75.3, R122.1, U25.P8
SDA25: 0X76.2, J76.3, J77.3, J78.3, R127.1, U26.P8
SDA26: 0X79.2, J79.3, J80.3, J81.3, R132.1, U27.P8
SDA27: 0X82.2, J82.3, J83.3, J84.3, R137.1, U28.P8
SDA28: 0X85.2, J85.3, J86.3, J87.3, R142.1, U29.P8
SDA29: 0X88.2, J88.3, J89.3, J90.3, R147.1, U30.P8
SDA30: 0X91.2, J91.3, J92.3, J93.3, R152.1, U31.P8
SDA31: 0X94.2, J94.3, J95.3, J96.3, R157.1, U32.P8
SDA32: 0X97.2, J97.3, J98.3, J99.3, R162.1, U33.P8
SDA33: 0X100.2, J100.3, J101.3, J102.3, R167.1, U34.P8
SDA34: 0X103.2, J103.3, J104.3, J105.3, R172.1, U35.P8
SDA35: 0X106.2, J106.3, J107.3, J108.3, R177.1, U36.P8
SDA36: 0X109.2, J109.3, J110.3, J111.3, R182.1, U37.P8
SDA37: 0X112.2, J112.3, J113.3, J114.3, R187.1, U38.P8
SDA38: 0X115.2, J115.3, J116.3, J117.3, R192.1, U39.P8
SDA39: 0X118.2, J118.3, J119.3, J120.3, R197.1, U40.P8
SDA40: 0X121.2, J121.3, J122.3, J123.3, R202.1, U41.P8
SDA41: 0X124.2, J124.3, J125.3, J126.3, R207.1, U42.P8
SDA42: 0X127.2, J127.3, J128.3, J129.3, R212.1, U43.P8
SDA43: 0X130.2, J130.3, J131.3, J132.3, R217.1, U44.P8
SDA44: 0X133.2, J133.3, J134.3, J135.3, R222.1, U45.P8
SDA45: 0X136.2, J136.3, J137.3, J138.3, R227.1, U46.P8
SDA46: 0X139.2, J139.3, J140.3, J141.3, R232.1, U47.P8
SDA47: 0X142.2, J142.3, J143.3, J144.3, R237.1, U48.P8
