sparkfun/SparkFun_Tristimulus_Color_Sensor-OPT4048/(commit log)

2023-06-12 Removes micro outline, adds mini outline
    [SparkFun_Color_Sensor_OPT4048.brd, SparkFun_Color_Sensor_OPT4048.sch, SparkFun_Color_Sensor_OPT4048_Mini.brd, SparkFun_Color_Sensor_OPT4048_Mini.sch, SparkFun_Micro_Color_Sensor_OPT4048.brd, SparkFun_Micro_Color_Sensor_OPT4048.sch]
2023-06-12 Adds OPT4048 device, adds to Qwiic board
    [SparkFun_Color_Sensor_OPT4048.brd, SparkFun_Color_Sensor_OPT4048.sch]
2023-06-13 Routes the Qwiic board
    [SparkFun_Color_Sensor_OPT4048.brd, SparkFun_Color_Sensor_OPT4048.sch]
2023-06-13 Routes Qwiic board
    * Adds ADDR2 jumper for SDA
    [SparkFun_Color_Sensor_OPT4048.brd, SparkFun_Color_Sensor_OPT4048.sch]
2023-06-14 Improves ground pour
    * Improves schematic aesthetic
    [SparkFun_Color_Sensor_OPT4048.brd, SparkFun_Color_Sensor_OPT4048.sch]
2023-06-14 Finishes routing Qwiic mini
    * Adds silk to Qwiic mini
    * Adds ordering instructions
    [SparkFun_Color_Sensor_OPT4048.brd, SparkFun_Color_Sensor_OPT4048.sch, SparkFun_Color_Sensor_OPT4048_Mini.brd, SparkFun_Color_Sensor_OPT4048_Mini.sch]
2023-06-16 Changes Jumper selection, moves resistors away from IC, and changes decoupling cap to smaller package
    [SparkFun_Color_Sensor_OPT4048.brd, SparkFun_Color_Sensor_OPT4048.sch]
2023-06-16 Adds some restrict near the ground pin for better ground pour
    [SparkFun_Color_Sensor_OPT4048.brd]
2023-06-16 Changes address selection on the mini
    [SparkFun_Color_Sensor_OPT4048.brd, SparkFun_Color_Sensor_OPT4048_Mini.brd, SparkFun_Color_Sensor_OPT4048_Mini.sch]
2023-06-16 Places version number on the bottom out from under the Qwiic connector
    [SparkFun_Color_Sensor_OPT4048_Mini.brd]
2023-06-16 Approves some DRC errors
    [SparkFun_Color_Sensor_OPT4048_Mini.brd]
2023-06-16 Fixes some traces
    [SparkFun_Color_Sensor_OPT4048_Mini.brd]
2023-06-16 Adds correct red LEDs and their resistors, updates PROD_ID for part.
    [SparkFun_Color_Sensor_OPT4048.brd, SparkFun_Color_Sensor_OPT4048.sch, SparkFun_Color_Sensor_OPT4048_Mini.brd, SparkFun_Color_Sensor_OPT4048_Mini.sch]
2023-06-16 Fixes SKU in designs, some DRC errors
    * Adds proto gerbers
    [SparkFun_Color_Sensor_OPT4048.GBL, SparkFun_Color_Sensor_OPT4048.GBO, SparkFun_Color_Sensor_OPT4048.GBP, SparkFun_Color_Sensor_OPT4048.GBS, SparkFun_Color_Sensor_OPT4048.GKO, SparkFun_Color_Sensor_OPT4048.GTL, SparkFun_Color_Sensor_OPT4048.GTO, SparkFun_Color_Sensor_OPT4048.GTP]
2023-07-19 Rolls version
    [SparkFun_Color_Sensor_OPT4048.brd, SparkFun_Color_Sensor_OPT4048.sch, SparkFun_Color_Sensor_OPT4048_Mini.brd, SparkFun_Color_Sensor_OPT4048_Mini.sch]
2023-07-19 Adds jumper to interrupt pin on both designs
    [SparkFun_Color_Sensor_OPT4048.brd, SparkFun_Color_Sensor_OPT4048.sch, SparkFun_Color_Sensor_OPT4048_Mini.brd, SparkFun_Color_Sensor_OPT4048_Mini.sch]
2023-07-19 Revert "Adds jumper to interrupt pin on both designs"
    This reverts commit a39334068ad88ec2875ce3e39fad74091b9d5839.
    [SparkFun_Color_Sensor_OPT4048.brd, SparkFun_Color_Sensor_OPT4048.sch, SparkFun_Color_Sensor_OPT4048_Mini.brd, SparkFun_Color_Sensor_OPT4048_Mini.sch]
2023-07-21 Adds PCB version to panel zip file
2023-07-21 Adds second Qwiic label, spins version number
    [SparkFun_Color_Sensor_OPT4048.brd]
2023-07-21 Adds production files
    [SparkFun_Color_Sensor_OPT4048-Panel.GBL, SparkFun_Color_Sensor_OPT4048-Panel.GBP, SparkFun_Color_Sensor_OPT4048-Panel.GBS, SparkFun_Color_Sensor_OPT4048-Panel.GKO, SparkFun_Color_Sensor_OPT4048-Panel.GTL, SparkFun_Color_Sensor_OPT4048-Panel.GTO, SparkFun_Color_Sensor_OPT4048-Panel.GTP, SparkFun_Color_Sensor_OPT4048-Panel.GTS]
2023-08-28 Adding Hardware Assembly images
2023-09-06 Adding soldered assembly
